Tamako0401/AMa-s-RISCV/docs/platform.md

# CPU 仿真与板级地址约定

以下地址用于当前 CPU 回归和 RIB SoC：指令 ROM 与数据 RAM 分离，复位入口为 ROM 基址。CPU 扩展能力、测试保留区及验证边界见 [cpu-baseline.md](cpu-baseline.md)。

Architecture:
    RV32I
    little-endian
    ABI = ilp32

Reset vector:
    0x00000000 (soc_top 默认, CPU/SoC 测试用); 板级顶层设为 0x0000f800 (bootloader, 见 bootloader.md)

ROM (instruction):
    0x00000000 - 0x0000ffff
    64 KiB
    fetch port: read-only, wired directly to the CPU ibus (not through RIB)
    data port:  RIB slave 0, used for rodata/constants and bootloader writes

Fetch/data paths:
    ibus -> ROM fetch port          (dedicated, 1-cycle, no arbitration)
    dbus -> RIB master 1 -> ROM data port / RAM / peripheral bus
    RIB master 0 is unused
    => code must live in the ROM window; soc_top cannot fetch from RAM

RAM (data):
    0x10000000 - 0x1000ffff
    64 KiB

Stack:
    initial sp = 0x10010000

MMIO:
    RIB slot s2 (0x20000000) = video: registers + palette/sprites/map/tiles, see video.md
    RIB slot s3 (0x30000000) is free
    RIB slot s4 (0x40000000) = peripheral bus, 4 KiB per port by addr[15:12]:
        0x40000000 unused (reads return zero, writes discarded)
        0x40001000 UART (CTRL/STATUS/BAUD/TXDATA/RXDATA at 0/4/8/C/10)
        0x40002000 SPI  (CR1/CR2/SR/DR at 0/4/8/C)
        0x40003000 GPIO matrix (all board pins, including UART/SPI)
        0x40004000 SYSCTL (HW_ID/ROM_WE)
        0x40005000 vision input (color tracking, see vision.md)
        0x40006000 handnet accelerator (registers, see nn.md)
        0x40007000 UART2 (same registers as UART; pins chosen by the GPIO matrix, unconnected at reset)
        0x40008000 audio (square + noise channels, I2S out via the GPIO matrix, see audio.md)
    CPU/SoC tests reserve RAM word 0x10000000 for completion

Interrupt:
    none

CSR:
    inherited M-mode CSR/trap paths; basic directed tests only

Misaligned access:
    unsupported initially
