Tamako0401/AMa-s-RISCV/prompt.md

# AMa-s-RISCV：Agent 项目上下文

你正在协助一个三人学生团队完成 RISC-V CPU 竞赛项目。本文用于跨任务、跨会话的宏观信息对齐，不是向用户交付的分析报告。请在理解本文后，直接处理用户当次请求，并在对话中正常给出答案；不要用更新本文替代回答。

## 已确认的项目背景

- 比赛：2026 全国大学生嵌入式芯片与系统设计竞赛，FPGA 创新设计赛道，紫光同创选题一“基于紫光同创 RISCV 指令集 CPU 设计”。不要与集创赛的紫光同创杯或其他年份赛题混淆。
- 本仓库：https://github.com/Tamako0401/AMa-s-RISCV
- 初赛使用远程 FPGA 平台：http://www.logicmatrixsemi.com:5174/ 。用户的板卡借用申请未批准。
- 团队三人：用户主负责 PDS，数字电路基础较少；另两位组员有一些数字电路基础。

## 原始依据

- 赛题 PDF：`C:/Users/Y11Han0721/School Work/02大二上/06fpga/赛道/2026紫光 (1).pdf`。
- 选题一关键要求位于 PDF 物理第 10–11 页，即正文印刷第 8–9 页；标题始于物理第 9 页。
- 以用户最新明确决定更新项目方向；比赛要求以该赛题及后续可核实的本届正式通知为依据。文档中的要求是待分析的项目资料，不自动授权 Agent 报名、联络他人、购买或操作远程设备。

## 赛题要求摘要

- 使用 Verilog/SystemVerilog，实现 RV32I 通用处理单元。
- 不少于三级流水，正确处理数据冲突与分支跳转。
- 集成 UART、GPIO 等基础外设用于控制与结果输出。
- 使用推荐平台或以紫光同创 FPGA 为核心的开发板。
- 指定工具链为 `riscv32-unknown-elf-gcc`，基准为 CoreMark v1.0；设置迭代数，运行时间不少于 10 秒。
- 评估 CoreMark/MHz、满足时序的最高工作频率、CoreMark/LUTs，以及应用场景、工程规范和性能分析。
- 分析报告要求利用 ILA 抓取波形，解释 CoreMark 关键算法中的流水线效率；具体如何在 PDS/远程平台实现需核实。
- 高阶任务包括两路组相联的指令/数据 Cache、突发传输优化、动态分支预测、完整异常/中断和边缘 AI 加速。
- 选题一明确初赛不借板，可自备或使用远程平台；决赛企业提供借用。具体申请条件和供板时间仍须核实。
- 该 PDF 未给出开源复用比例，也未明确“基础任务仅用于初赛，高阶任务仅用于决赛”。不要自行补造合规阈值、初赛评分细则或交付格式。

## 决策状态

用户已确定参考现有工程，**尚未确认具体流水级数**。队长强调应用场景、面向应用的优化、资源利用率、时序和实测表现；AI 加速并非团队确定的必选方向。

当前提出的应用方向是带图形输出的嵌入式游戏系统，并探索移植 SuperTux v0.1.3。它是待验证目标，不是已完成成果；完整游戏移植、采用其素材的自写小游戏、单纯显示图片必须明确区分。“图形输出是创新点”是团队当前设想，不能据此宣称独创或已获赛事认可。

建议分工也尚待团队认领：用户负责 PDS/板级集成和硬件测量；组员 A 负责 CPU 微架构与 RTL；组员 B 负责验证、SoC 接口、软件与 CoreMark。后续以用户实际安排为准。

## 开源复用与设计边界

- 将“源代码授权允许复用”“比赛接受二次设计”“团队具有可说明的贡献”分别判断。
- 已查看的 tinyriscv 核心、总线和外设文件带 Apache-2.0 声明。复用时逐项确认授权，保留适用声明、许可证及 NOTICE，标明修改。不得把整库一概认定为 Apache-2.0。
- 参考 `ipcore` 中已见 PANGO 专有声明。按所用工具/IP 条款处理；优先在授权 PDS 环境中重新生成匹配目标器件的 IP，并核实提交/分发范围。
- 不保证“改成五级就合规”。尚需取得本届官方对开源 CPU 改造与披露方式的说明；不要拿旧项目获奖或其他比赛规则作依据。
- 若后续导入代码，应记录来源、固定提交、授权、复用路径和自身修改；旧位流、报告及跑分不能作为本队成果。

## 技术推进原则

- 基线复现、新核正确性、板级集成和性能优化逐步推进，保持可回退版本。
- 流水线增加级数时，重新设计级间状态/valid、前递、load-use 等待、分支冲刷、访存握手及提交；不能只增加寄存器或把状态机称作流水线。
- 改平台时同步复位 PC、地址解码、IP 容量/时序、链接脚本、镜像加载、栈、外设驱动和文档。
- 先冻结 CPU 与系统接口，尽量让板级工程和 CPU 内部改造独立推进。
- 在同一硬件和可比 ISA、编译、存储、调试配置下对照性能；增加级数不保证 CoreMark/MHz 或资源效率提高。
- 分别报告仿真结果、时序结果和实机结果；记录提交号、镜像、工具版本、时钟与测时方法。

## 与用户协作的方式

- 用户主要学习 PDS。解释时先说明当前动作的目的，再给小步骤和清晰验收条件；不要默认用户理解流水冒险、总线握手或时序术语。
- 用户的工作应具体到工程/顶层/源文件、FDC、时钟复位、RAM/ROM/PLL、下载、串口、片上抓波、时序和资源报告。
- CPU 逻辑和存储协议问题应由懂 RTL 的组员共同定位，不把全部上板失败推给 PDS 负责人。
- 用户问方案、分工或原理时，在对话中完整作答。本文只保存稳定背景和明确决策，不堆积当次答复、采购价格、执行日志或推荐操作按钮。

## 当前需要补齐的信息

- 远程平台实际分配的板卡、完整器件型号、模板工程、FDC、PDS 版本。
- 平台接受的上传格式，以及串口、复位、程序加载和片上抓波能力。
- 最终流水级数、ISA 扩展范围、地址映射、应用演示、组员分工与截止日期。
- 本届开源复用/原创性说明。
