Tamako0401/AMa-s-RISCV/docs/hand-model.md

# 徒手手势模型

目标: 摄像头画面里找一只手, 给出手掌中心位置和握拳 / 张开两种手势, 控制游戏 (东方类: 位置控制自机, 握拳放 bomb;
水果忍者: 张开时挥手出刀光)。先在 Python 里验证, 达标后再做成 FPGA 上的加速器。
为什么不用颜色标记或帧差: 见 [vision.md](vision.md) 的算法试验。

## 先试玩: 手势控制能不能玩

训练自己的模型之前, 先用 MediaPipe 当输入把游戏做成能玩的原型 (`model/play.py`, 东方式弹幕):
握拳移动控制自机, 张开一下放 bomb。摄像头放在桌面附近、拍不到脸。

- 对照: 按 M 换鼠标玩同一关。鼠标也躲不过是游戏太难, 鼠标能玩、手不能玩才是输入的问题。
- 按 0~3 给手的位置加噪声 (160x120 画面里 σ = 0/1/2/4 点), 看多大的误差还能玩, 作为自己模型位置精度的验收线。
- 每局结束终端打印: 坚持几秒、得分、被击中几次、用了几个 bomb、摄像头帧率、没找到手的比例、识别耗时。

```sh
model/play.py models/gesture_recognizer.task                 # 第二个参数可以换摄像头编号
model/play.py models/gesture_recognizer.task --record ps front # 边玩边录, 之后用 label.py 标注
model/play.py models/gesture_recognizer.task --student model/runs/<名字>.pt   # 用自己训练的模型玩
```

`--student` 时游戏由自己的模型控制, MediaPipe 照样跑, 只在小窗里画出来对照 (绿点 MediaPipe, 红圈自己的模型),
屏幕上显示热力图分数; `--threshold` 改"分数低于多少算没找到手" (默认 0.5)。

画面和录数据一样, 是镜像后裁成 4:3 的 640x480 (板子 HDMI 输入看到的范围)。

## 流程和进度

| 步骤 | 脚本 | 状态 |
| --- | --- | --- |
| 1. 按固定动作清单录 640x480 画面 | `model/record.py` | 已写 |
| 2. MediaPipe 当老师自动标注 | `model/label.py` | 已写 |
| 3. 抽查标注, 手工点一批真值 | `model/check.py` | 待写 |
| 4. 训练小 CNN (浮点) | `model/handnet.py`、`model/train.py` | 已写, 第一版结果见结论记录 |
| 5. 评估 (按人分开的测试集) | `train.py` 里 (每 10 轮按段打表), `--val-person` 按人留出 | 等多人数据 |
| 6. 比较输入尺寸 (80x60 / 160x120 / 320x240) 和网络宽度 | 同上 | 待做 |
| 7. 实时试玩: 平滑、手势防抖、简单自机和刀光 | `model/demo.py` | 待写 |
| 8. INT8 量化, 写整数参考实现 (以后 C 和 RTL 的标准答案) | `model/nn_export.py`、`model/nnref.py` | 已写, RTL 见 [handnet 加速器](nn.md); 权重还要用真实数据重训 |

## 录数据、汇总、训练

全部在仓库里做, 数据放 `model/data/`, 训练结果放 `model/runs/`, MediaPipe 模型放 `models/`; 这三处都不进 git
(`.gitignore`)。脚本是 `uv run --script`, 第一次运行自动装依赖。训练有 NVIDIA 显卡 (CUDA) 或 Mac (MPS) 就用, 否则用 CPU。

第一次准备 (每台机器一次):

```sh
mkdir -p models && curl -L -o models/gesture_recognizer.task \
  https://storage.googleapis.com/mediapipe-models/gesture_recognizer/gesture_recognizer/float16/latest/gesture_recognizer.task
```

每个人、每种场景录一次, 再标注:

```sh
model/record.py <人> <场景>          # 跟着屏幕提示做 13 段动作, 约 2 分钟; 存到 model/data/<日期>_<人>_<场景>_<时分秒>/
model/label.py models/gesture_recognizer.task model/data/<刚录的目录>   # MediaPipe 自动标注, 打印每段统计
```

- **人**: 同一个人每次用同一个名字 (字母数字, 如 ps、yh), 训练时按它分训练集和验证集。
- **场景**: front (顺光)、back (逆光, 比如背后是窗)、messy (背景杂乱) 等, 名字自己定, 统计里按它分开数。
- 摄像头在显示器上方对着人, 手在胸前 (见上面"结论记录": 平拍不好玩, 老师也认不出手势)。
- 录多少: 至少 4~5 个人, 每人 2~3 种场景。一次约 1000 帧、70 MB, 15 次约 1 GB。
- 边玩边录也算数据, 正好是游戏里真实的手部动作: `model/play.py models/gesture_recognizer.task --record <人> <场景>`。

汇总不同人的数据: 每次录制是一个自带全部信息的目录 (图片 + `meta.json` 记着人和场景, 标注后多一个 `labels.npz`),
目录名带时间, 不会重名。所以汇总就是**把这些目录都放进训练那台机器的 `model/data/`**:

- 别人在自己电脑上录: 装好仓库后照上面录, 把 `model/data/<目录>` 打包 (zip) 发过来, 解压到 `model/data/`。
  没标注的在这边补跑 `label.py`。数据太大不走 git, 用网盘或 U 盘。
- 或者人来这台机器前录, 直接就在 `model/data/` 里。

训练 (`model/data` 下所有标注过的 session; 一个人整个留出来当验证集, 看对没见过的人好不好用):

```sh
model/train.py model/data --val-person ps --width 16
```

开训前会按人、场景打印 session 数和帧数, 看数据偏不偏。存到 `model/runs/w16_160_<时间>.pt`。
最后导出给硬件 (标定直接用录的数据):

```sh
model/nn_export.py model/runs/<名字>.pt --calib model/data   # 改写 rtl/nn/ 的权重和 tests/nn/ 的测试向量
./ama test tests/nn                                         # RTL 和整数参考逐字节对上
```

### 外部数据: HaGRID

自己录的人少、背景少。补上 HaGRID (https://github.com/hukenovs/hagrid, 上万人用手机拍的手势照片, 许可 CC BY-SA 4.0,
用了要在文档和答辩材料里注明出处) 的 384p 抽样版
(https://huggingface.co/datasets/cj-mills/hagrid-sample-120k-384p, 3.5 GB zip, 同样 CC BY-SA 4.0), 只用 fist、palm、stop 三类:

```sh
mkdir -p model/external   # 不进 git
curl -L -C - -o model/external/hagrid-sample-120k-384p.zip \
  https://huggingface.co/datasets/cj-mills/hagrid-sample-120k-384p/resolve/main/hagrid-sample-120k-384p.zip
model/import_hagrid.py model/external/hagrid-sample-120k-384p.zip   # 每类 2000 张 -> model/data/<日期>_hg00..hg09_hagrid_000000
model/label.py models/gesture_recognizer.task model/data/*_hg*_hagrid_*   # 照片逐张标 (IMAGE 模式)
```

导入时裁成 4:3、让手占画面宽度 10%~25% (和摄像头在显示器上方时差不多), 再缩到 640x480; 同一个人的照片在同一组,
组名 hg00..hg09 当人名, 所以 `--val-person` 仍然只该留自己录的真人 (要看的是对我们摄像头好不好用)。
都是静止照片, 没有运动模糊和逆光, 补不了这些, 只补人和背景的多样性。

## 结构试验

默认结构的最后一格在 160x120 里只看得到约 47x47 点 (感受野), 手离镜头近时有 60~80 点大, 第一次训练的漏检里
"手太近太大"是一类。`train.py` 有两个选项扩大感受野, 先在 PyTorch 里比漏检和 P95, 明显变好再改硬件:

| 选项 | 感受野 | 乘加 / 帧 (宽度 16) | 参数 | 硬件 |
| --- | --- | --- | --- | --- |
| 默认 | 约 47 点 | 6.44 M | 13.9 k | 支持 |
| `--dw-k 5` (不缩小的块用 5x5 深度卷积) | 约 79 点 | 7.06 M | 15.9 k | 支持 (2026-10-27 起, 现在导出的默认结构) |
| `--extra 1` (多一个不缩小的块) | 约 63 点 | 7.84 M | 18.8 k | 层表支持, `nn_export.py` 还要跟着加层 |
| `--dw-k 5 --extra 1` | 约 111 点 | 8.76 M | 21.9 k | 两样都要 |

`nn_export.py` 遇到 `--extra` 不为 0 的模型会直接报错, 不会导出硬件跑不了的权重。

## 数据

一次录制 (session) 是一个目录: 帧图片 (640x480 JPEG, 已左右镜像)、`meta.json` (人、场景、每帧属于哪段和时间戳)、
`labels.npz` (标注)。动作清单在 `record.py` 的 `SEGMENTS`, 按游戏的玩法排 (平时握拳移动, 张开一下放 bomb;
摄像头在显示器上方对着人, 手在胸前): 握拳 / 张开静止、握拳移动、握拳快速移动、移动中张开一下、转手 (掌心 / 侧面 / 手背)、换另一只手、
远近移动、手进出画面边缘、手在脸附近, 以及没有手、脸凑近 (负样本)、两只手。每段记着"应该看到什么" (写在 `meta.json`),
`label.py` 用它找标注的问题。`play.py --record` 录的段名是 `play`, 不核对。

存的是 640x480 原图, 训练时再缩到要的尺寸, 缩小方法和硬件一样 (`box4` 的整块平均)。这样比较 80x60 / 160x120 /
320x240 或以后换分辨率都不用重录。2026-10-23 第一次录制用的是旧清单 (摄像头对着人、平时张开), 照样能用。

`labels.npz` 每个字段第一维是帧, 最多记两只手 (按左右排); 坐标都是 0..1 的比例, 换成任何分辨率乘宽高即可:

| 字段 | 形状 | 意思 |
| --- | --- | --- |
| `files`、`segment` | N | 图片文件名、属于哪段 |
| `hands` | N | 找到几只手 |
| `points` | N×2×21×2 | MediaPipe 的 21 个关键点; 没有的手是 NaN |
| `center` | N×2×2 | 手掌中心: 手腕和四个指根 (0、5、9、13、17 号点) 的平均 |
| `teacher`、`teacher_score` | N×2 | Gesture Recognizer 的结果: 0 握拳, 1 张开, -1 其他; 置信度 |
| `ratios`、`rule` | N×2×4、N×2 | 四指 (指尖到手腕) / (指根到手腕), 和按它判的手势 |
| `gesture` | N×2 | 最终手势: 一路说不清时听另一路, 两路矛盾或都说不清为 -1 (训练时不算) |

录数据的要求: 测试集里的人不能出现在训练集 (所以 `record.py` 要写人名); 人数比总帧数重要, 目标 6~10 人、每人
2~3 种光线和背景。

## 网络

`model/handnet.py`。输入 160x120 (从 640x480 每 4x4 块取平均, 和硬件 `box4` 一样), 输出 20x15 个格, 每格 4 个数:

```
160x120x3 ─ 3x3 卷积 /2 ─ 80x60xW ─ 可分离 /2 ─ 40x30x2W ─ 可分离 /2 ─ 20x15x4W ─ 可分离 ×2 ─ 1x1 卷积 ─ 20x15x4
                                                                                            ├ 热力图 (手心在这格的分数)
可分离 = 3x3 深度卷积 + 1x1 卷积 (MobileNet)                                                  ├ 格内偏移 dx, dy
W = 宽度 (--width)                                                                           └ 握拳的分数
```

找手: 取热力图最高的格, 分数 ≥ 0.5 算有手; 手心 = (格 + 偏移) × 8; 手势读同一格。没有上采样和跳连 (不是 UNet)。

训练 (`model/train.py`): 损失 = 热力图 focal loss + 偏移 L1 + 手势交叉熵, 后两项只在手心那格算。
数据增强: 左右翻转、平移缩放、每通道颜色增益、亮度对比度、噪声、模糊。

## 用到的方法

只记确实在用或确定会用的; 每条一句话说清楚它是什么、我们为什么用。

- **伪标签训练 (老师-学生)**: 用一个准但大的模型 (老师, MediaPipe) 给数据自动打标签, 拿来训练一个小模型 (学生)。
  省掉手工标注; 代价是学生会学到老师的错, 所以要抽查, 还要一批人工真值来量误差。
  这是广义的知识蒸馏 (Hinton 2015), 更接近 Radosavovic 2018 的 *Data Distillation*。
- **MediaPipe Hands / Gesture Recognizer** (Zhang 2020, arXiv 2006.10214): Google 的手部模型, 先在整张图 (192x192)
  上找手掌, 再在手的区域里出 21 个关键点; Gesture Recognizer 在此基础上分 7 种手势, 包括 Closed_Fist、Open_Palm。
  它专门检测手掌而不是整只手, 理由是手掌形状固定好找, 我们取手掌中心也是这个道理 (握拳不会让中心跳)。
- **两路标签交叉检查**: 手势同时用老师的分类和手指弯曲比例的规则判; 一路说不清时听另一路, 两路矛盾就不用这帧。
  规则用 MediaPipe 的 world 坐标 (以手为原点的三维坐标), 手转个角度比值也不怎么变。
- **按人划分测试集**: 同一个人既在训练集又在测试集, 模型会记住这个人的手和背景, 指标虚高。
- **CenterNet 式输出** (Zhou 2019, *Objects as Points*): 网络输出一张粗网格 (比如 20x15) 的热力图, 手心所在格分数最高;
  再输出格内的小数偏移, 精度就不受格子大小限制。不需要 UNet 那种放大回原图的解码器, 硬件上省存储。
- **focal loss** (Lin 2017, RetinaNet): 热力图上几乎全是背景格, 普通损失会被背景淹没; focal loss 降低"已经判对的
  简单格"的权重, 让训练集中在难的格上。
- **深度可分离卷积** (MobileNet, Howard 2017): 主干用它, 计算量比普通卷积少 8~9 倍。
- **One Euro 滤波** (Casiez 2012): 平滑位置, 手慢时多平滑 (去抖), 手快时少平滑 (不拖尾)。用在 CPU 后处理。
- **量化感知训练** (Jacob 2018): 训练时就模拟 INT8 的取整误差, 让模型适应; 硬件上只用整数乘加。做到第 8 步时再展开。

## 结论记录

按日期往下记: 用了什么数据、什么配置、指标多少、得出什么结论。

- 2026-10-23: `record.py`、`label.py` 写好。`label.py` 用 MediaPipe 示例图试过: 竖拇指时规则判握拳、老师判 Thumb_Up,
  两路不一致标 -1, 符合预期。
- 2026-10-23 第一次录制 (ps, 顺光, 1273 帧, USB 摄像头):
  - 没有手、脸凑近两段老师 0 误检; 两只手段 99% 找到两只。
  - 手势两路**从未直接矛盾**, 只是各有说不清的时候: 老师常对移动中的拳头给 None (move_fist 22%), 规则常对移动中
    微弯的张开手说不清 (比值掉到 1.5 左右)。原来"两路一致才用"会丢掉约 1/5 的移动帧, 正好是游戏里最常见的状态,
    所以改成一路说不清时听另一路。改后忽略比例: 移动握拳 6%、切换 4%、换手 11%。
  - 规则比值: 握拳静止 0.58~0.88, 张开静止 1.63~1.85, 阈值 1.2 / 1.6 先不动。
  - 老师漏检: other_hand 段开头约 20 帧是在换手、画面里确实没手 (标对了); 真漏的是拳头在画面边缘、
    快速挥手的模糊帧、**手挡在脸前**。所以训练时"没有手"的负样本只取 no_hand / face 段, 有手的段里老师没找到手的帧
    不当负样本, 直接不用; 手挡脸是游戏里常见的姿势, 老师在这里弱, 要靠 check.py 手工补标。
- 2026-10-23 第一次试玩 (`play.py`, Mac 前置摄像头 30 帧/秒, MediaPipe 识别约 22 ms/帧, 噪声 0, 平滑开):
  正常两局坚持 46、47 秒, 被击中 3、2 次, bomb 3 个都用了, 没找到手 6%、0%。
  弹幕密度 (第一级圆环、自机狙、螺旋) 能躲; 过程中自机没有跳, 手势没有误识别。结论: 位置 + 两种手势的控制方式可行。
  试玩后改成平时握拳、张开一下放 bomb (原来反过来), 防抖改成两个方向都要连续 3 帧才切换。
- 2026-10-23 噪声试玩 (同上设置, 每档只玩了 1~3 局, 差异只能看大方向):

  | 噪声 σ | 平滑 | 坚持 (秒) |
  | --- | --- | --- |
  | 1 | 开 | 37、26、47 |
  | 2 | 开 | 26、54 |
  | 2 | 关 | 22 |
  | 1 | 关 | 11 (这局 49% 没找到手, 不算) |

  - **平滑必须开**: 关掉后自机一直在抖, 主观感受"超级离谱"; 开着时 σ=1、2 都能玩, 两档分不出明显差别。
  - 这里的噪声是每帧独立的高斯抖动 (围着真实位置跳), 平滑能压掉大半, 所以影响不大, 主观上只是要往弹幕稀的地方躲。
    自己的模型的误差不一定是这样: 可能有固定偏差 (某些手势中心整体偏一点) 或偶尔跳到别处, 这两种平滑压不掉,
    评估时要单独统计 (P95 误差、大于 10 点的次数)。
  - 平滑越强越稳但越滞后, 要在精度和延迟之间取平衡。暂定验收线: 160x120 下位置误差 σ ≤ 2 点, 配默认 One Euro 参数。
- 2026-10-23 试了摄像头放桌面平拍 (USB 免驱摄像头, 画面裁成 4:3):
  - 试玩明显变难: 三局坚持 16、40、19 秒 (之前对着人时 46、47 秒)。手离镜头近, 在画面里很大, 能移动的范围小;
    手要伸远一些, 也不在平时的位置, 控制别扭。
  - 老师的手势分类几乎全失效: 各段 83%~100% 给"其他" (平拍多是拳头侧面, 不像它训练时见过的掌心朝镜头),
    手势只剩规则一路在判; 找手本身还是 96%~100%。
  - 结论: 摄像头回到显示器上方对着人, 手放在胸前。录制清单加回"脸凑近"(负样本) 和"手在脸附近移动",
    训练后专门看脸上的误检。
- 2026-10-23 第一次训练 (只有 ps 一个人; 训练: front_003156、desk_012710、两次边玩边录, 约 5000 帧;
  验证: face_013812, 新清单、摄像头对着人; 输入 160x120, 30 轮, Mac 的 GPU 上每轮约 8 秒):

  | 网络 | 乘加 / 帧 | 参数 | 漏检 | 误差中位 | P95 | >10 点 | 脸上误检 | 手势对 |
  | --- | --- | --- | --- | --- | --- | --- | --- | --- |
  | 宽度 8 | 2.3 M | 4.2 k | 32% | 3.8 | 21.2 | 14% | 21% (15/75) | 96% |
  | 宽度 16 | 6.4 M | 13.9 k | 23% | 3.6 | 25.2 | 16% | 0% | 96% |
  | 宽度 16 + 左右翻转 | 6.4 M | 13.9 k | 21% | 2.8 | 11.4 | 7% | 0% | 99% |

  误差单位是 160x120 画面里的点, 和老师 (MediaPipe) 的手心比。
  - 换手段误差一直在 19 点左右: 画出来看, 是另一只手 (左手) 的拳头, 学生把点放在拳头中间, 老师在靠手腕一侧。
    训练数据几乎只有右手; 加左右翻转后这段中位误差 19.5 → 6.8, 整体 P95 25 → 11。
  - 手和脸能分开: 宽度 16 在只有脸的帧上 0 误检, 手在脸前 (near_face) 中位误差 2.6。
  - 主要问题是漏检 (21%), 多在手转到侧面 (turn)、换手、手太近太大、半只手在边上; 分数常在 0.2~0.4,
    阈值 0.5 可能偏高。下一步: 学生模型接进 play.py 试玩, 看漏检对手感的影响; 找更多人录数据。
- 2026-10-23 第一次用自己的模型试玩 (`play.py --student`, 宽度 16 + 左右翻转那版, 阈值 0.5):
  三局坚持 43、18、80 秒 (MediaPipe 时 44、47 秒), 没找到手 8%、1%、1%, 自己的模型每帧约 5 ms (CPU)。
  主观: 已经可用。少量突然的中短距离跳变, 有几段小幅抖动, 不如 MediaPipe 平滑。
- 2026-10-27 结构和外部数据对比 (宽度 16, 30 轮, RTX 上训练; 验证集同上 face_013812, 1500 个有手帧):

  | 训练数据 | 结构 | 漏检 | 误差中位 | P95 | >10 点 | 手势对 |
  | --- | --- | --- | --- | --- | --- | --- |
  | ps 4 次 (同 10-23) | 默认, 跑两次 | 27%、28% | 3.8、3.8 | 21.6、18.3 | 13%、13% | 97%、96% |
  | ps 4 次 | `--dw-k 5`, 跑两次 | 15%、13% | 3.1、3.7 | 16.8、15.8 | 10%、11% | 97%、93% |
  | ps 5 次 (加 10-27 那次) | 默认 | 28% | 3.0 | 16.0 | 9% | 99% |
  | ps 5 次 + HaGRID 6000 张 | 默认 | 39% | 2.9 | 8.3 | 4% | 99% |

  - **5x5 深度卷积 (感受野 47 -> 79 点) 漏检减半**, 两次都是, 不是随机波动。硬件已经加上 (层表的核大小可以是 5, 见 docs/nn.md)。
  - **HaGRID 让定位准很多** (P95 16 -> 8.3, 换手段 27 -> 22, 远近段 30 -> 5.7), 但漏检反而多了: 照片里都是
    静止、清楚、掌心朝镜头的手, 模型对我们的模糊、侧面、半只手更不敢说 "有"。下一步: HaGRID 少放一些或降权,
    和 `--dw-k 5` 一起试, 再看阈值 (现在 0.5) 要不要按验证集调。
