Tamako0401/AMa-s-RISCV/boards/ego1/pins.xdc

# 由 ama gen pins 生成, 不要手改
set_property PACKAGE_PIN B16 [get_ports {io[0]}]
set_property IOSTANDARD LVCMOS33 [get_ports {io[0]}]
set_property SLEW SLOW [get_ports {io[0]}]
set_property DRIVE 4 [get_ports {io[0]}]
set_property PACKAGE_PIN B17 [get_ports {io[1]}]
set_property IOSTANDARD LVCMOS33 [get_ports {io[1]}]
set_property SLEW SLOW [get_ports {io[1]}]
set_property DRIVE 4 [get_ports {io[1]}]
set_property PACKAGE_PIN A15 [get_ports {io[2]}]
set_property IOSTANDARD LVCMOS33 [get_ports {io[2]}]
set_property SLEW SLOW [get_ports {io[2]}]
set_property DRIVE 4 [get_ports {io[2]}]
set_property PACKAGE_PIN A16 [get_ports {io[3]}]
set_property IOSTANDARD LVCMOS33 [get_ports {io[3]}]
set_property SLEW SLOW [get_ports {io[3]}]
set_property DRIVE 4 [get_ports {io[3]}]
set_property PACKAGE_PIN A13 [get_ports {io[4]}]
set_property IOSTANDARD LVCMOS33 [get_ports {io[4]}]
set_property SLEW SLOW [get_ports {io[4]}]
set_property DRIVE 4 [get_ports {io[4]}]
set_property PACKAGE_PIN A14 [get_ports {io[5]}]
set_property IOSTANDARD LVCMOS33 [get_ports {io[5]}]
set_property SLEW SLOW [get_ports {io[5]}]
set_property DRIVE 4 [get_ports {io[5]}]
set_property PACKAGE_PIN B18 [get_ports {io[6]}]
set_property IOSTANDARD LVCMOS33 [get_ports {io[6]}]
set_property SLEW SLOW [get_ports {io[6]}]
set_property DRIVE 4 [get_ports {io[6]}]
set_property PACKAGE_PIN A18 [get_ports {io[7]}]
set_property IOSTANDARD LVCMOS33 [get_ports {io[7]}]
set_property SLEW SLOW [get_ports {io[7]}]
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
set_property PACKAGE_PIN T4 [get_ports {io[69]}]
set_property IOSTANDARD LVCMOS33 [get_ports {io[69]}]
set_property SLEW SLOW [get_ports {io[69]}]
set_property DRIVE 4 [get_ports {io[69]}]
set_property PACKAGE_PIN N5 [get_ports {io[70]}]
set_property IOSTANDARD LVCMOS33 [get_ports {io[70]}]
