Tamako0401/AMa-s-RISCV/sw/bsp/mes2l100hp_pins.h

/* 由 ama gen pins 生成, 不要手改 */
#define PIN_LCD_SCK 0
#define PIN_LCD_MOSI 1
#define PIN_LCD_CS 2
#define PIN_LCD_DC 3
#define PIN_LCD_RST 4
#define PIN_LCD_BL 5
#define PIN_EXP1 6
#define PIN_EXP2 7
#define PIN_KEY1 8
#define PIN_KEY2 9
#define PIN_KEY3 10
#define PIN_KEY4 11
#define PIN_LED1 12
#define PIN_LED2 13
#define PIN_LED3 14
#define PIN_LED4 15
#define PIN_LED5 16
#define PIN_LED6 17
#define PIN_LED7 18
#define PIN_LED8 19
#define PIN_UART_TX 20
#define PIN_UART_RX 21
#define PIN_HDMI_RSTN 22
#define PIN_HDMI_SCL 23
#define PIN_HDMI_SDA 24
#define PIN_CAM_PCLK 25
#define PIN_CAM_VSYNC 26
#define PIN_CAM_HREF 27
#define PIN_CAM_XCLK 28
#define PIN_CAM_D0 29
#define PIN_CAM_D1 30
#define PIN_CAM_D2 31
#define PIN_CAM_D3 32
#define PIN_CAM_D4 33
#define PIN_CAM_D5 34
#define PIN_CAM_D6 35
#define PIN_CAM_D7 36
#define PIN_CAM_SCL 37
#define PIN_CAM_SDA 38
#define PIN_CAM_RST 39
#define PIN_CAM_PWDN 40
#define PIN_WS_TX 41
#define PIN_WS_RX 42
#define PIN_WS_EN 43
#define PIN_WS_IO9 44
#define PIN_PHY_RX 45
#define PIN_PHY_TX 46
#define PIN_AMP_BCLK 47
#define PIN_AMP_LRCK 48
#define PIN_AMP_DIN 49
#define PIN_AMP_SD 50
#define PIN_EXT29 51
#define PIN_EXT30 52
#define PIN_EXT31 53
#define PIN_EXT32 54
#define PIN_EXT33 55
#define PIN_EXT34 56
#define PIN_EXP35 57
#define PIN_EXP36 58
#define PIN_SD_SCK 59
#define PIN_SD_MOSI 60
#define PIN_SD_MISO 61
#define PIN_SD_CS 62
#define PIN_SD_DET 63
