Tamako0401/AMa-s-RISCV/sw/bsp/mes50hp_pins.h

/* 由 ama gen pins 生成, 不要手改 */
#define PIN_J8_3 0
#define PIN_J8_4 1
#define PIN_J8_5 2
#define PIN_J8_6 3
#define PIN_J8_7 4
#define PIN_J8_8 5
#define PIN_J8_9 6
#define PIN_J8_10 7
#define PIN_J8_11 8
#define PIN_J8_12 9
#define PIN_J8_13 10
#define PIN_J8_14 11
#define PIN_J8_15 12
#define PIN_J8_16 13
#define PIN_J8_17 14
#define PIN_J8_18 15
#define PIN_J8_19 16
#define PIN_J8_20 17
#define PIN_J8_21 18
#define PIN_J8_22 19
#define PIN_J8_23 20
#define PIN_J8_24 21
#define PIN_J8_25 22
#define PIN_J8_26 23
#define PIN_J8_27 24
#define PIN_J8_28 25
#define PIN_J8_29 26
#define PIN_J8_30 27
#define PIN_J8_31 28
#define PIN_J8_32 29
#define PIN_J8_33 30
#define PIN_J8_34 31
#define PIN_J8_35 32
#define PIN_J8_36 33
#define PIN_PMOD_1 34
#define PIN_PMOD_2 35
#define PIN_PMOD_3 36
#define PIN_PMOD_4 37
#define PIN_PMOD_7 38
#define PIN_PMOD_8 39
#define PIN_PMOD_9 40
#define PIN_PMOD_10 41
#define PIN_KEY2 42
#define PIN_KEY3 43
#define PIN_KEY4 44
#define PIN_KEY5 45
#define PIN_KEY6 46
#define PIN_KEY7 47
#define PIN_KEY8 48
#define PIN_LED1 49
#define PIN_LED2 50
#define PIN_LED3 51
#define PIN_LED4 52
#define PIN_LED5 53
#define PIN_LED6 54
#define PIN_LED7 55
#define PIN_LED8 56
#define PIN_UART_TX 57
#define PIN_UART_RX 58
#define PIN_HDMI_RSTN 59
#define PIN_HDMI_SCL 60
#define PIN_HDMI_SDA 61
#define PIN_HDMI_RX_SCL 62
#define PIN_HDMI_RX_SDA 63
