Tamako0401/AMa-s-RISCV/sw/bsp/ego1_pins.h

/* 由 ama gen pins 生成, 不要手改 */
#define PIN_J5_1 0
#define PIN_J5_2 1
#define PIN_J5_3 2
#define PIN_J5_4 3
#define PIN_J5_5 4
#define PIN_J5_6 5
#define PIN_J5_7 6
#define PIN_J5_8 7
#define PIN_J5_9 8
#define PIN_J5_10 9
#define PIN_J5_11 10
#define PIN_J5_12 11
#define PIN_J5_13 12
#define PIN_J5_14 13
#define PIN_J5_15 14
#define PIN_J5_16 15
#define PIN_J5_17 16
#define PIN_J5_18 17
#define PIN_J5_19 18
#define PIN_J5_20 19
#define PIN_J5_21 20
#define PIN_J5_22 21
#define PIN_J5_23 22
#define PIN_J5_24 23
#define PIN_J5_25 24
#define PIN_J5_26 25
#define PIN_J5_27 26
#define PIN_J5_28 27
#define PIN_J5_29 28
#define PIN_J5_30 29
#define PIN_J5_31 30
#define PIN_J5_32 31
#define PIN_S0 32
#define PIN_S1 33
#define PIN_S2 34
#define PIN_S3 35
#define PIN_S4 36
#define PIN_SW0 37
#define PIN_SW1 38
#define PIN_SW2 39
#define PIN_SW3 40
#define PIN_SW4 41
#define PIN_SW5 42
#define PIN_SW6 43
#define PIN_SW7 44
#define PIN_DIP0 45
#define PIN_DIP1 46
#define PIN_DIP2 47
#define PIN_DIP3 48
#define PIN_DIP4 49
#define PIN_DIP5 50
#define PIN_DIP6 51
#define PIN_DIP7 52
#define PIN_LD2_0 53
#define PIN_LD2_1 54
#define PIN_LD2_2 55
#define PIN_LD2_3 56
#define PIN_LD2_4 57
#define PIN_LD2_5 58
#define PIN_LD2_6 59
#define PIN_LD2_7 60
#define PIN_LD1_0 61
#define PIN_LD1_1 62
#define PIN_LD1_2 63
#define PIN_LD1_3 64
#define PIN_LD1_4 65
#define PIN_LD1_5 66
#define PIN_LD1_6 67
#define PIN_LD1_7 68
#define PIN_UART_TX 69
#define PIN_UART_RX 70
