Tamako0401/AMa-s-RISCV/(commit log)

2026-09-13 feat(sw): 新增链接脚本和主程序文件
    同步队友的最新更改
2026-09-19 feat(experiments): 添加 8 位寄存器及自检仿真测试
2026-09-25 feat(rtl): 移植基础数据通路和通用组件并记录来源
2026-09-25 feat(peripherals): 移植 GPIO 和可配置时钟的 UART
2026-09-25 test(rtl): 添加移植组件自检与接入说明
2026-09-27 feat(cpu): add CSR interrupt and divider support
2026-09-29 feat(perips): add the ROM and RAM bus slaves
    去 IP 化移植上游的 ram.v/rom.v: 存储体改用 rtl/utils/gen_ram.v, 总线侧沿用
    perips 已有的 valid/ready 约定(req_valid/req_ready + rsp_valid/rsp_ready),
    因此可以直接挂到 rib 的从设备端口。
    - rom.v: 只读, 初值由 $readmemh 从 ROM_INIT_FILE 载入; DP 真正决定深度
    (上游的 DP 是死参数, 实际用的是硬编码位宽)。
    - ram.v: 复用 gen_ram; 写使能包含握手(we_i & req_valid_i & req_ready_o),
    主设备保持 we_i 等待响应时不会重复写入。
    - 一并挂进 rtl/reusable.f, 并新增组件回归 tests/reusable/memory_tb.sv。
2026-09-29 feat(core): default the reset vector to the ROM base
    哈佛式布局下指令存储器(ROM)位于 0x0000_0000, 复位向量随之从 0x8000_0000 改为
    0x0000_0000, 与 rtl/core/rib.v 的从设备译码一致。
    cpu_tb 一直是显式传参(.RESET_PC(BASE)), 所以这个默认值的改动不影响既有的
    核级仿真基线。
    [ifu.v, tinyriscv_core.v]
2026-09-29 test(cpu): move the baseline harness to the Harvard memory map
    - link.ld: 单区域 -> ROM 0x0000_0000(.text/.rodata) + RAM 0x1000_0000
    (.data/.bss/栈); RAM 窗口第 0 个字保留为"运行结束"信箱, 可用 RAM 从 +4 开始。
    - cpu_tb.sv: 单数组 -> rom[]/ram[] 两块独立模型, +image= 改为 +rom=/+ram=;
    取指只走 ROM, 数据总线可读 ROM(.rodata 常量)但写被忽略, 与 rom.v 行为一致。
    - memory.S: 自改写代码用例在哈佛下本质上不成立(ROM 不可写, 也不能从 RAM 取指),
    改为验证"写 ROM 必须被忽略"——仍是 fence.i + jal/ret 的覆盖。
    验证: 15 组程序/延迟配置全部 PASS。
2026-09-29 refactor(sw): point link.ld at the Harvard memory map
    sw/link.ld 原先把代码、数据和栈全放在 0x8000_0000 一块统一内存里, 改成与
    rtl/core/rib.v 的从设备译码一致的两区布局: ROM 0x0000_0000(.text/.rodata,
    也是复位向量) + RAM 0x1000_0000(.data/.bss/栈)。
    sw/startup.S 与 sw/main.c 不需要改动: 它们只用链接器符号(_stack_top、
    _bss_start/_bss_end、__global_pointer$), 不含硬编码地址。
    与 tests/cpu/link.ld 的差异是有意的: 那边把 RAM 窗口第 0 个字留给仿真结果
    信箱, 可用 RAM 从 +4 开始; 本文件面向实机程序, 程序原地停机, 不保留信箱。
2026-09-29 test(cpu): build the two images the Harvard harness expects
    cpu_tb 改成双存储器后, 测试台改用 +rom= 与 +ram= 两个镜像参数, 但构建脚本
    没有同步: 它仍然只导出二进制并传 +image=, 因此在那个提交点上跑
    python scripts/test-cpu.py 会立刻 $fatal("Missing +rom=hex")。本次补齐:
    - 用 llvm-objcopy --only-section 分别导出 .text(ROM) 与 .data(RAM);
    - 两个镜像都补齐到 64 KiB: ROM 未初始化部分填 0xa5(非法指令), RAM 数据区
    之后填 0xa5, 继续保证 startup 真正清 BSS;
    - vvp 参数由 +image= 改为 +rom= / +ram=;
    - 按 link.ld 约定, .data 之前补 4 字节, 把 RAM 窗口第 0 个字留给结果信箱;
    - memory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
2026-09-29 test(reusable): run the memory regression from test-reusable.nu
    上一批次新增了 rtl/perips/rom.v、ram.v 和 tests/reusable/memory_tb.sv, 并把
    它们挂进了 rtl/reusable.f, 但脚本的测试列表没跟上, memory_tb 不会被这个脚本
    跑到。补上列表项。
    验证: storage / alu / peripherals / memory 四组均 PASS。
2026-09-29 docs: record the Harvard memory map and the baseline conventions
    - platform.md: 复位向量 0x0000_0000; 指令存储器 ROM 0x0000_0000-0x0000_ffff
    (64 KiB, 只读); 数据存储器 RAM 0x1000_0000-0x1000_ffff(64 KiB); 栈顶 0x1001_0000。
    - cpu-baseline.md: 仿真侧同步为哈佛式双存储模型, 记录"取指只走 ROM、数据总线
    可读 ROM 但写被忽略"以及"向 RAM 窗口第 0 个字写 4 字节表示结束"的信箱约定;
    另加"已知环境问题"一节, 说明 Icarus 13 无法展开 rtl/core/exu_muldiv.v
    (div_ready 先用后声明), 本机因此跑不了 test-cpu.py。
2026-09-29 feat(soc): add the valid/ready RIB interconnect
    rib.v 是处理器核与从设备之间的总线互连(2 个主设备 x 5 个从设备), 主从两侧都
    用 valid/ready 握手。上游也有一个 valid/ready 版 rib, 但它的响应路由依赖
    "当前仲裁结果 + 当前地址", 而本核在请求握手后就撤 req_valid(见 exu_mem 的
    pending/ifu 的 WAIT), 会把响应送回错误的主设备。
    本次重写为在请求握手时锁存事务归属(owner + 目标从设备), 并去掉旧版依赖的
    defines.v 宏(MemAddrBus/MemBus/HoldEnable 等, 本仓库已不存在)和 hold_flag_o。
    同时新增 rtl/soc.f, 把 rib 纳入可编译的文件清单。
2026-09-29 feat(soc): add the core+memory SoC top and its smoke test
    - rtl/soc_top/soc_top.v: 例化 tinyriscv_core + rib + rom + ram, 按哈佛映射把
    ibus/dbus 接到 rib 的 m0/m1、ROM 接 s0、RAM 接 s1(各 64 KiB, 与 link.ld 一致);
    s2~s4 保留(不握手), 留给后续的 uart/gpio/spi。
    - tests/soc/: SoC 级测试台直接跑在 RTL 的 rib+rom+ram 上(核级回归用的是测试台
    自己的行为级存储模型), 另有专用冒烟程序; 测试台还检查 rib 的互斥性 ——
    任一时刻最多一个从设备被选中、最多一个主设备收到响应。
    - scripts/test-soc.py: 构建并运行该用例。
    验证: PASS SoC cycles=1193 stores=19。
2026-09-29 feat(perips): preload RAM contents from an init file
    soc_top 里的 ram.v 之前没有初值支持, RAM 上电内容是未知值, 因此任何带已初始化
    .data 的程序都无法在 SoC 上运行(之前的 SoC 冒烟程序只能刻意绕开 .data)。
    - rtl/utils/gen_ram.v: 新增可选 INIT_FILE 参数, 用守卫生效的 $readmemh 载入
    存储初值; 文件名为空则完全不初始化, 行为向后兼容。
    - rtl/perips/ram.v: 新增 RAM_INIT_FILE, 透传给 gen_ram。
    - rtl/soc_top/soc_top.v: 新增 RAM_INIT_FILE, 透传给 u_ram。
    - tests/reusable: 新增 ram_init.mem; memory_tb 的 RAM 改为带初值实例, 并在
    任何写之前逐字读回校验。
    - tests/soc: 新增 soc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
2026-09-29 feat(perips): add the SPI master
    从上游移植 spi master 模块(rstl 高有效风格, 无 valid/ready 总线接口)。
    注意: 它还没有接入 SoC —— rib 的从设备侧是 valid/ready 握手, 而本模块仍是
    旧式接口(data_i/addr_i/we_i + data_o), 因此接上去之前需要先写一层总线包装;
    目前也不在任何 .f 清单或回归里。
2026-09-29 refactor(perips): adapt the SPI master to the peripheral bus protocol
    rtl/perips/spi.v 是从别的项目复制过来的, 其接口是本仓库早已废弃的旧风格, 无法
    挂到 rib 上。SPI 移位状态机本身没有缺陷, 本次只改接口层, 收发逻辑一行未动。
    - rst -> rst_n: 原代码的复位判断写的是 rst == 1'b0, 即它本来就是低有效, 只是
    端口名有误导性。本次统一成仓库惯用的 rst_n(7 处判断, 无语义变化)。
    - 新增 sel_i[3:0] 字节使能: 原来 we_i 一到就整字写入, 字节/半字写会误伤同一字
    的其它字节。SPI_CTRL/SPI_DATA/SPI_DC 三个可写寄存器改为按字节写, 与 gpio.v、
    uart.v 一致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
2026-09-29 feat(soc): wire the SPI master into the RIB at slave 2
    - rtl/soc_top/soc_top.v: rib 的从设备 2 从"保留、不握手"改为接入 spi, 地址
    0x2000_0000; 新增 6 个顶层引脚 spi_mosi/spi_miso/spi_ss/spi_clk/lcd_dc/
    lcd_rst_n; 从设备 3/4 仍然保留。头部注释同步更新地址映射。
    - rtl/soc.f: 把 spi.v 纳入 SoC 文件清单。
    - tests/soc/soc_spi.S: 新增。5 次写, 全部通过总线读写 SPI 寄存器 -- DC 复位值、
    DC 回读、CTRL 回读(bit0 自清)、sb 字节写、STATUS 只读; 最后启动一次传输并轮询
    STATUS[0] 由忙转闲, 证明重构后状态机仍然会跑。这是第一条走通
    dbus -> rib -> spi 这条从设备通路的程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
2026-09-29 feat(difftest): 加入.tohost使得满足条件后spike可以停止
2026-09-29 fix: 修复一个先使用后声明
2026-09-29 feat(difftest): 加入commit log日志开关
2026-09-29 feat(difftest): 加入一个简单的difftest
2026-09-29 fix: 修改链接脚本以适应哈佛架构
2026-09-30 feat(board): add verified MES50HP minimal system and firmware
2026-09-30 docs(platform): reconcile CPU baseline, board layout and provenance
2026-09-30 feat(spi): adopt CR1 SR DR and GPIO screen controls
2026-09-30 docs(spi): document register migration and verification
2026-10-01 fix(uart): 在cpu没空时保存uart要给的值不丢掉
2026-10-01 feat(soc): 将uart接入到s3并将gpio 8~15连接led
2026-10-01 feat(bus): 加入外设子总线
2026-10-01 refactor(soc): 把gpio, uart和spi挂到外设子总线s4下
2026-10-01 feat(sw): 分层sw, spi/lcd驱动以及lcd_demo
2026-10-01 docs(axi): 对axi的真实控制器部分的补充
2026-10-02 docs(readme): 更新 README 文件以反映当前项目进展和系统配置
2026-10-03 test(spi): test spi display in simulator
2026-10-04 feat(ci): 添加 GitHub Actions 工作流以自动运行 Icarus/Verilator 验收测试
2026-10-07 feat: Enhance minimal SoC with SPI support and LCD integration
    - Updated minimal_soc.v to include SPI interface and control signals for the LCD.
    - Modified build-board.py to support building firmware for SPI LCD demo.
    - Implemented lcd_main.c for SPI LCD demonstration, showcasing basic graphics.
    - Added board_lcd_tb.sv for testing the LCD functionality in the simulation environment.
    - Adjusted GPIO configurations to accommodate new peripherals and ensure correct operation.
    - Enhanced ST7789 initialization sequence in st7789.c for improved compatibility.
    [board_lcd_tb.sv, board_tb.sv, lcd_main.c, main.c, mes50hp_top.v, minimal_soc.v, st7789.c]
2026-10-08 feat: 更新 README 和脚本以支持 LCD 上板SRAM快速测试，添加引脚约束核对报告
2026-10-09 fix(ci): 板级测试台改用例化参数覆盖，修复 Verilator 报错
    CI 上 Verilator 不支持带层级路径的 defparam (dut.soc.MEM_FILE)，
    导致 board_tb/board_lcd_tb 编译失败；本地无 Verilator 回退 Icarus
    故未暴露。改为 mes50hp_top 透传 MEM_FILE 参数、测试台在例化时以
    #(.MEM_FILE("sim.hex")) 覆盖，Icarus/Verilator 均兼容；参数默认值
    仍为 firmware.hex，PDS 位流行为不变。本地两步板级仿真均 PASS。
    [board_lcd_tb.sv, board_tb.sv, mes50hp_top.v]
2026-10-09 fix: 使用bsrr切换led, 避免影响其他gpio
2026-10-16 feat(sw): .data 初值放 ROM, 启动时拷到 RAM, 复位行为与单片机一致
    片上存储不随复位恢复, 原来 .data 只靠配置时预装 RAM, 程序改过的变量
    在复位后不会回到初值。
    - sw/link.ld: .data > RAM AT > ROM, 导出 _data_load/_data_start/_data_end
    - sw/startup.S: 清 BSS 前把 .data 初值从 ROM 拷到 RAM
    - scripts/elf2hex.py: 按 ELF 程序头的存放地址生成 ROM 镜像, 单独负责 ELF -> hex
    - scripts/test-lcd.py: 改用 elf2hex.py, 只给 +rom=; 加 --tb 选择测试台
    - sw/app/reset_check + tests/soc/reset_tb.sv: 改掉变量后复位, 检查初值恢复
    ram.v 的 RAM_INIT_FILE 保留, CPU 回归 (tests/cpu、test-soc、difftest) 仍在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
    [lcd_tb.sv, main.c, reset_tb.sv]
2026-10-16 feat(sw): UART 驱动和上板自检程序 board_check
    - sw/device/amarisc.h: UART 寄存器 (0x4000_1000)
    - sw/drivers/uart.{c,h}: 轮询收发; uart_init 写成 inline, 常量参数下编译期算分频
    (rv32i 无除法指令, -nostdlib 下运行时除法链接不到 __udivsi3)
    - sw/bsp: LED/调试串口接线, bsp_cycles / bsp_ms_to_cycles
    - sw/app/board_check: 打印 AMA CPU PASS/FAIL n, 回显, LED 流水; 改掉有初值的
    变量, KEY1 复位后检查是否从 ROM 恢复。输出与 sw/board/main.c 相同, 复用板级测试台
    - justfile、test-lcd.py 的源文件列表加上 uart.c
    [amarisc.h, bsp.c, bsp.h, main.c, uart.c, uart.h]
2026-10-16 feat(board): soc_top 上板 (build-board.py --harvard)
    - boards/mes50hp/mes50hp_top_harvard.v: soc_top 的板级顶层, 端口与模块名同
    mes50hp_top.v, 共用 mes50hp.fdc 和板级测试台; KEY1 异步复位同步释放, RX 两级同步
    - scripts/build-board.py --harvard: 固件用 sw/ (startup.S、link.ld, app 为
    board_check 或 --lcd 时 lcd_demo), ROM 镜像用 elf2hex.py, RTL 用 rtl/soc.f;
    输出 build/mes50hp-harvard[-lcd]。不加 --harvard 时 minimal_soc 流程不变
    - tests/board/board_lcd_tb.sv: -DHARVARD 时按 soc_top 的 u_core 取总线信号
    - CI: 加哈佛版板级仿真、LCD 仿真和复位恢复测试
    - boards/mes50hp/README.md: 哈佛版用法与验收
    仿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
2026-10-16 fix(uart): 软件写 STATUS 的那一拍不再跳过硬件更新
    STATUS 原先用一个 if/else: 软件写 STATUS (清 RX 完成标志) 的那一拍, else 里的
    硬件更新整个被跳过。两种后果, 都只在恰好同拍时发生:
    - 正好是 TX 停止位结束: TX busy 永远不清, putc 死等, 串口再也不出字;
    - 正好收完一个新字节: RX 完成标志被清掉, 这个字节丢失。
    改为两个标志各自更新: TX busy 只由硬件置位/清除; RX 完成标志接收置位优先于软件清除。
    tests/reusable/uart_status_tb.sv 在两个事件前后各扫 3 拍写入时刻, 修复前两项都在
    偏移 0 失败, 修复后通过; 已加入 test-reusable.nu (CI 组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
    [uart.v, uart_status_tb.sv]
2026-10-16 fix(sw): bsp_ms_to_cycles 改为 static inline, 避免 clang 18 生成 __mulsi3 调用
    [bsp.c, bsp.h]
2026-10-16 test(soc): reset_tb 超时改用计数器, 兼容 Verilator 5.020
    [reset_tb.sv]
2026-10-16 feat(sw): 移植 CoreMark 到 soc_top (sw/app/coremark, scripts/coremark.py, build-board.py --app coremark)
2026-10-16 ci: 拆成并行 job 并加 lint; CoreMark 支持 gcc 并检查性能底线
    - ci.yml: 固定 ubuntu-24.04, permissions: contents: read, concurrency 取消旧运行,
    每个 job 设超时; Nushell 下载包校验 SHA-256; cpu / soc / board / coremark / lint
    五个 job 并行, 失败时上传日志
    - coremark.py: --cc gcc (赛题指定工具链)、--min-score 性能底线、--summary 结果表;
    CI 中 clang 与 gcc 各跑一次 (ubuntu-24.04 实测 clang 18 0.558, GCC 13.2 0.660)
    - check-coremark-upstream.py: 校验 third_party/coremark 与官方 1f483d5 逐字节一致
    - lint job: ruff、actionlint、CoreMark 原样性; verilator -Wall 只报告不阻断
    - build-board.py / test-cpu.py: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
2026-10-16 ci: coremark 安装步骤的数组改名, 通过 actionlint 的 shellcheck 检查
2026-10-16 feat(boards): 支持在 EGO1 (Artix-7) 上构建哈佛 SoC 位流
    boards/ego1: ego1_top 例化 mes50hp_top, MMCM 把 100 MHz 分成 50 MHz,
    S6 (低有效) 作复位; build-board.py --board ego1 --harvard [--app coremark] --vivado
    在 distrobox 里跑 Vivado。MES50HP 构建不变。
    Vivado 2025.2 实测: board_check WNS +0.732 ns / 4157 LUT, coremark WNS +1.009 ns / 7477 LUT。
2026-10-16 fix(rtl): rom 地址寄存器去掉异步复位, 让 ROM 推断成块 RAM
    带异步复位的 addr_r 无法映射到 BRAM, 综合器只能用 LUT 搭整个 ROM, LUT 随程序变大。
    EGO1 (Vivado 2025.2) 实测: board_check 4157 -> 3223 LUT, coremark 7477 -> 3223 LUT,
    RAMB36 16 -> 32, WNS +1.009 -> +0.250 ns。复位后的 addr_r 不被读取 (rsp_valid_o 由
    vld_rdy 给出), 仿真周期数不变; 实机 board_check 与 CoreMark 均通过。
    [rom.v]
2026-10-16 test(directed): 补充已知缺陷的定向复现测试
2026-10-16 feat(boards): build-board.py 支持 --cc gcc, 用于 CoreMark 正式报分
2026-10-16 fix(uart): 上电和复位期间保持 TX 空闲高电平
    UART 的 tx_bit 复位值为 0 且没有上电初值, EGO1 在 S6 按下或 MMCM
    未锁定时把 TX 拉低, 主机将其视为起始位。根因在 UART 输出寄存器,
    因此修改 rtl/perips/uart.v 的初值和复位值, 不在板级或固件绕过。
    新增 uart_reset_tb, 从无时钟的上电阶段开始检查引脚, 按 115200 8N1
    解码真实 board_check 固件, 覆盖停钟和正常时钟下的重复复位。
    接入 build-board.py --harvard --simulate, 不改 CI。
    修复前 1 ns 即因 TX=0 失败; 复位波形另可见 120.32 us 的低电平。
    回归: SoC 4 项、CPU 15 项、组件、SPI、reset_check、EGO1/MES50HP
    Harv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
    [uart.v, uart_reset_tb.sv]
2026-10-18 feat(rtl): GPIO 矩阵、可写 ROM 和系统控制寄存器
    新增 gpio_matrix (0x4000_3000), 仿 ESP32: 任何外设信号可以接到任何引脚。
    板上所有资源 (扩展口、按键、开关、LED、串口) 都接进位流, 接什么由 C 运行时
    决定, 接新外设或换插针不再改 .v、不再综合。寄存器名照抄 ESP32 (OUT/W1TS/
    W1TC/ENABLE/IN/FUNC_OUT_SEL/FUNC_IN_SEL), 规格见 docs/gpio-matrix.md。
    控制台串口也经矩阵, 复位默认接板载 USB 转串口, 不配置就能用。
    地址按字段直接选寄存器: 最初逐引脚比较地址的写法有 30 级逻辑,
    EGO1 50 MHz 下 WNS -1.09 ns。
    为串口 bootloader 加两样硬件 (docs/bootloader.md):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
2026-10-18 refactor(sw): 外设驱动改用 GPIO 矩阵, 屏幕移出 bsp
    - 新驱动 sw/drivers/io.h: io_dir / io_write / io_read / io_connect_out /
    io_connect_in, 用 W1TS/W1TC 写, 不做读改写。
    - bsp 只描述板子本身: 按 BOARD_EGO1 / BOARD_MES50HP 选引脚头文件,
    去掉基于旧 GPIO 的 LED/按键/屏幕引脚定义。
    - 屏幕是插上去的模块, 不属于板子: bsp/bsp_lcd.c 移到
    components/lcd/lcd_io.c。app 用 lcd_pins_t 按名字给出屏幕接在哪几个脚,
    调对应的 lcd_init_xxx; SPI 模式和最高速度是屏幕芯片的参数, 由驱动自己定。
    宽高由驱动初始化时设置 (lcd_width/lcd_height), 去掉 LCD_W/LCD_H 编译宏。
    - 新增 ST7735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
2026-10-18 feat(boards): 引脚表、矩阵板级顶层和串口 bootloader
    引脚表: boards/<板>/pins.csv 记录电路板上焊死的事实 (丝印名、管脚、方向),
    scripts/gen-pins.py 由它生成约束、顶层用的 pins_top.vh 和
    sw/bsp/<板>_pins.h (PIN_J5_1、PIN_S0、PIN_KEY2 ...), 三处不会对不上。
    - EGO1: J5 32 个插针、S0~S4、SW0~7、DIP0~7、16 个 LED、串口。
    - 盘古: J8 34 个 IO、PMOD 8 个、KEY2~8 (低有效, 顶层取反)、LED1~8、串口。
    复位键 (EGO1 S6、盘古 KEY1) 和时钟固定在顶层, 不进矩阵。
    板级顶层: ego1_top 改写、新增 mes50hp_top_matrix, 只有时钟、复位和一排 io;
    旧 mes50hp_top*.v 不动。
    串口 bootloader (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
    [pins.csv]
2026-10-18 feat(app): EGO1 自检程序和贪吃蛇
    ego1_check: 屏幕三色带加白框、5 个按键方块, LED 跟随按键, 串口每秒打印
    按键状态; 是 EGO1 位流里固化的默认程序, 新板子先跑它排查接线。
    snake: 网格按屏幕运行时宽高计算 (ST7735 128x160 每格 8 像素,
    ST7789 240x320 每格 10 像素)。
    - EGO1: S4/S3/S0/S1 方向, S2 开局/暂停; SW0 穿墙, SW1 串口控制, LD2-0/1 指示。
    - 盘古: KEY5~8 = h/j/k/l, KEY2 开局/暂停; KEY3 串口控制、KEY4 穿墙
    (按一下切换), LED3/4 指示。
    - 串口: wasd/hjkl 方向, p 或空格开局/暂停。
    - 穿墙关闭时撞墙结束; 撞死后停 1 秒, 免得按着方向键立刻重开。
    验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
2026-10-18 feat(tools): ama 上板工具 (uv + typer)
    日常改 C 不再综合: ama run <程序> 编译、经串口 bootloader 下载、显示串口
    输出, 几秒完成; 只有改了 rtl/、boards/、sw/boot/ 才用 ama fpga build /
    ama fpga program。命令名照 ESP-IDF、PlatformIO 的叫法:
    ama run | build | upload | monitor | sim <程序>
    ama fpga build | program
    - 依赖写在脚本头部 (PEP 723), 由 uv 自动安装 typer、pyserial。
    Linux/macOS 直接 ./ama, Windows 用 uv run --script ama。
    - 板子按 USB 串口芯片识别 (FT2232 = EGO1, CP2102 = 盘古), 也可 --board。
    - 下载前核对板上位流的 HW_ID; fpga build 在位流旁记下 HW_ID,
    fpga program 拒绝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
2026-10-18 fix(build): 修正 MES50HP 板的比特流文件路径和 HW_ID 参数写入编码
2026-10-20 refactor(sw): 按键组件、app 板级接线、屏幕 shield, 三个自检程序合成 selftest
    - components/key: 定时采样 + 消抖, key_ticks 每轮调一次, key_rose/key_fell/key_status 只读
    - app 的板级差异放 sw/app/<app>/boards/<板>/ (app_board.h/.c), ama 编译时按板子加 -I 和源文件;
    snake 改用它, main.c 不再出现板子名
    - bsp/shield_lcd.h: 每块板约定的屏幕型号和接线, app 调 shield_lcd_init()
    - selftest 取代 board_check、ego1_check、lcd_demo: CPU 自检 -> 测试图 -> LED 流水、回显、按键方块
    (README、位流和板级测试台下一步改)
    - ama fpga build/program 必须写程序名, 不再按板子写死默认程序
    - ama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
2026-10-20 refactor: minimal_soc 整套移到 legacy/, 盘古只留一个 mes50hp_top
    - legacy/minimal_soc/: minimal_soc.v、它的板级顶层和约束、sw/board 固件、board_lcd_tb、
    board_reset 缺陷复现; 不再构建, README 说明来源和最后可用的提交
    - 删 mes50hp_top_harvard.v (没人用); mes50hp_top_matrix.v -> mes50hp_top.v,
    matrix.fdc -> mes50hp.fdc
    - build-board.py 去掉 minimal_soc 路径和 --lcd; 板级测试台去掉 HARVARD 分支
    过渡状态: build-board.py 和 CI 下一步由 ama 取代。
2026-10-20 refactor(ama): ama 成为唯一编译固件和生成位流的工具, 删 build-board.py
    - 代码挪进 tools/ama/ (cli、boards、firmware、fpga、load), 根目录 ama 只是入口
    - boards/<板>/board.toml 描述工具、器件、顶层、约束、USB 串口芯片、位流文件名
    - ama build <app> 出 build/fw/<板>/<app>/{app.elf,boot.elf,rom.hex}; 需要额外源文件的 app
    写 sw/app/<app>/app.toml (只有 coremark)
    - ama fpga build <app> 在 build/fpga/<板>-<app>/ 生成工程, build.tcl 用相对路径,
    PDS 可经 pds_remote 命令在虚拟机里跑; ama gen pins <板> 取代 gen-pins.py
    - 删 scripts/build-board.py、elf2hex.py、hwid.py、load.py、gen-pins.py
    - ama.local.t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
2026-10-20 refactor(test): ama test 取代所有测试脚本, CI 只跑 ama test
    - 每个测试目录一个 tests.toml ([[test]]: tb、rtl、extra、params、runs、expect、sim),
    tools/ama/testing.py 一段通用代码解释; ama test [目录|测试台]
    - 默认 verilator; sw/app/<app>/test/ 用电脑的 cc 编译运行
    - ALU 程序固定为 tests/cpu/alu.S; reset_check 挪到 tests/soc/ (reset_tb 的测试固件)
    - CoreMark 在固件里算 CoreMark/MHz 并和 -DMIN_SCORE 比较, 仿真用的 ITERATIONS 由测试传入
    - 板级测试台改用 selftest, boot_tb 自己算下载镜像的长度和 CRC
    - 删 scripts/*.nu、test-cpu.py、test-soc.py、test-lcd.py、test-directed.py、coremark.py、
    chec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
    [board_tb.sv, boot_tb.sv, cli.py, coremark_tb.sv, firmware.py, lcd_tb.sv, reset_check.c, reset_tb.sv]
2026-10-20 feat(sim): ama sim 跑任意程序, 实时窗口显示屏幕, 终端显示串口
2026-10-20 refactor(ama): 本机工具统一成同名命令的替身, ama doctor 列命令和版本
2026-10-20 feat(ama): ama lint / ama fmt, 带 --fix 才改文件
    [cli.py, firmware.py, lint.py, local.py]
2026-10-20 style: ama fmt --fix 统一 Python/C/Verilog 格式
    [alu_tb.sv, amarisc.h, axi_bridge.v, axi_bridge_tb.sv, axi_slave_model.sv, board_tb.sv]
2026-10-20 docs: 只删除过时、放错位置和混乱的内容
2026-10-20 refactor(ama): 固件只用 riscv64-unknown-elf-gcc, 去掉 --cc 和 clang
2026-10-20 docs(ama): ama 的 README 和命令图; 删 load.py 的旧命令行入口
2026-10-20 fix(ama): compile_commands.json 合并而不是覆盖
2026-10-20 refactor(sim): sim 外壳例化 mes50hp_top 当虚拟盘古板, 引脚编号来自 pins_top.vh
2026-10-20 feat(sim): 窗口里打字经串口送进程序
2026-10-20 fix(rtl): gpio_matrix 复位不在循环里对数组非阻塞赋值, verilator 5.020 能编
    [gpio_matrix.v]
2026-10-20 fix(ama): gcc 链接加 --nmagic, bootloader 没进 ROM 的问题; ROM 分区只在 sw/memory.ld; 硬件版本号补漏; FPGA 工具查表; 烧写按板; 测试台用 PIN_ 名字; ram_init 字段; 测试结果显示 [result]
    [board_tb.sv, boot_app.c, boot_tb.sv, cli.py, firmware.py, fpga.py, lcd_tb.sv, load.py]
2026-10-20 refactor(ama): 编译器按赛题叫 riscv32-unknown-elf-gcc, 没有就在 ama.local.toml 里起别名
2026-10-20 docs(sw): selftest 的 README; sw 分层表补全, 引脚功能只在 components/bsp 里选
2026-10-20 refactor(soc): 删旧 gpio.v 和不走矩阵的旧端口; gpio_matrix 的 genvar 改成 Verilog 写法 (PDS); fpga build 打印按模块资源表, 工具失败时给日志路径
2026-10-20 feat(ama): ama new <程序>, 从模板 sw/app/hello 复制
2026-10-20 docs(sw): snake、coremark 的 README
2026-10-20 ci: 测得的数值 (CoreMark/MHz) 写进运行摘要
2026-10-20 perf(core): ifu 改成预取队列加 epoch 丢弃, 同镜像 CoreMark/MHz 0.778 -> 1.113
    原来的 ifu 是 4 状态单笔事务状态机, 每条指令 IDLE/SEND/WAIT/FULL 各占一拍,
    实测 4.36 拍/条, 取指占了 CoreMark 测量窗口的 69%。
    改动:
    - 指令队列 + 在途标签队列: 队列还有余量就连续发请求, PC 不再等下游取走;
    - 标签记 {epoch, pc}, 响应按序配对, 交付的 pc 和 inst 永远来自同一次取指;
    - flush 只做 epoch+1、PC 改目标地址、清空指令队列; 在途响应照常接收后按
    epoch 丢弃, 不再等总线事务结束;
    - req_valid 拉高后保持到握手、期间地址不变, rsp_ready 恒为 1, 总线语义不变;
    -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
2026-10-20 style: 修 ama lint 报的问题 (rtl/core 以外); verible、clang-tidy 规则按代码库写法调整
    [alu_tb.sv, axi_bridge_tb.sv, boot_tb.sv, coremark_tb.sv, cpu_tb.sv, ego1_top.v, firmware.py, fpga.py]
2026-10-20 perf(soc): ROM 增加独立取指口, 取指不再和访存抢 rib
    rom.v 增加第二个只读口(i_*), 直接接 CPU 的 ibus; 原来接在 rib 上的口保留给
    数据访问(读 rodata/常量, bootloader 写 app 区)。两个口同拍访问互不阻塞。
    soc_top 把 ibus 从 rib 的主设备 0 改到 ROM 取指口, rib 主设备 0 保留未用。
    取指不再和 dbus 争同一笔总线事务。这是严格哈佛式划分: 指令必须位于 ROM
    窗口, soc_top 不再支持从 RAM 取指(现有链接脚本都把 .text 放在 ROM)。
    同一份 CoreMark 镜像 (3 次迭代, clang -O2, 50 MHz 仿真):
    4 状态机基线 3,854,726 ticks -> 0.778 CoreMark/MHz
    预取队列 + epo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
2026-10-20 ama: 位流默认只带 bootloader, --app 才固化程序; bootloader 见程序区为空就一直等下载
2026-10-20 ama: fpga program 默认写进 flash 上电自动加载, --once 只下载一次; 盘古改用 cdt_cfg_shell 命令行下载; docs: 参考项目
2026-10-20 video: HDMI 输出 640x480, 图块背景 + 16x16 精灵 + 调色板, 逐行渲染; MS7210 软件 I2C 初始化; 仿真窗口显示 HDMI; video_tb
    [pins.csv]
2026-10-20 sw: 软件 I2C 挪到 drivers, 速度由调用方传入, 不再依赖 bsp
2026-10-20 vision: HDMI 输入 -> 4x4 均值缩小 -> 160x120 小窗 (像素流各级可替换); MS7200 初始化; ama fpga report 打印每个模块和全片资源、各时钟余量
    [pins.csv]
2026-10-20 ama: fpga build 也必须写 --board (只和构建产物有关, 不按串口猜)
2026-10-21 model: 视觉算法 Python 试验 (帧差/消融/颜色标记, MediaPipe 当对照); docs: 试验结论
2026-10-21 vision: 颜色跟踪 (Cb/Cr 容差内的点数和坐标和, 寄存器 0x4000_5000, 和 model/color.py 逐位相同); video_demo 跟着红色标记画光标
2026-10-21 vision: 画面正中平均颜色寄存器, video_demo 串口 c 标定、+/- 调容差、打印位置
2026-10-21 sw: I2C 16 位寄存器地址改为低字节先发 (MS72xx 约定, 同盘古例程); 原来高字节在前, 自检读写同一地址照样通过, 其余寄存器全写错位置
2026-10-21 sw: MS72xx 每次寄存器读写后等 1 ms, 同盘古例程
2026-10-21 vision: 输入改为 800x600 (电脑最低只给这个), 裁出正中 640x480 再缩小; 仿真视频源改 800x600@60
2026-10-21 sw: MS7200 EDID 不再声明支持 YCbCr, 电脑只发 RGB
2026-10-21 perf(core): 访存不再多停一拍, 重定向当拍发出目标取指
    两处都只动 RTL, 不改编译器选项。
    1) exu_mem.v: 去掉多余的 done 拍
    原来是 请求握手 -> 响应 -> done -> 才放行 EX, 每条访存停 2 拍。done 只比
    响应晚一拍, 完全多余。现在响应那一拍就写回并放行 EX; 读数据在响应拍直接
    取总线值(rdata_sel), 其余时候用锁存值。pending 只由本条指令自己的请求置位,
    所以不会把前一条的响应误当自己的。
    mem_req_valid_o 也去掉 !done, 连续访存之间不再空一拍。
    2) ifu.v: 重定向当拍就发目标地址的请求
    原来 flush_i 把 issue_start 挡住, 目标地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
    [exu_mem.v, ifu.v]
2026-10-21 perf(core): 取指队列空时旁路响应, 重定向少等一拍
    原来的路径是 响应 -> 写指令队列 -> 下一拍从队列读出 -> 交给 ifu_idu, 队列为空
    时这一进一出纯属多余。现在队列空且下游这一拍就要拿走时, 直接把响应旁路到
    ifu_idu, 同时不进队列(避免重复交付)。
    停顿时下游拿不走, 这时必须常规入队, 否则这条指令会丢 —— fifo_bypass 的条件里
    带 !stall_i[STALL_ID] 就是为了这个。
    改动前 1,431,806 ticks -> 2.095 CoreMark/MHz
    改动后 1,329,197 ticks -> 2.257 CoreMark/MHz (+7.7%)
    省下的正好是每次重定向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
    [ifu.v]
2026-10-22 docs: 赛题要求与答疑要点; 修正过时内容 (HDMI 上板状态、输入分辨率问题、CoreMark 分数、复位地址)
2026-10-22 model: 手势数据录制 (record.py) 和 MediaPipe 自动标注 (label.py); docs: 徒手手势模型流程、方法和首次录制结论
2026-10-22 model: 手势弹幕试玩原型 (play.py, MediaPipe 输入, 可加位置噪声、开关平滑); docs: 试玩和噪声结论
2026-10-22 model: 录制清单按游戏玩法重排, play.py 改用 4:3 画面并可边玩边录; label.py 表头对齐、每段期望写进 meta.json; docs: 桌面平拍试验结论
2026-10-22 model: 手势小网络 (handnet.py) 和训练 (train.py, MediaPipe 标注当答案, 按段打验证指标); docs: 网络结构和第一次训练结果
2026-10-22 model: play.py 可用自己训练的模型控制 (--student, 小窗同时画 MediaPipe 对照); docs: 第一次用自己模型试玩
2026-10-22 docs: 显示扩展方案草案 (720p、逐行渲染 + 多图层、软硬件分工、预算和要验证的问题、游戏用 C 写并带电脑后端)
2026-10-22 video: 增加 720p 扫描和双时钟行缓存，保留 VGA 回退
2026-10-22 vision: 测量输入尺寸并整帧验证后发布居中裁剪结果
2026-10-22 test: 覆盖 SoC 和板级双显示模式并记录 HDMI 验证边界
2026-10-22 game: 东方式弹幕的 C 版 (游戏逻辑只用整数, 板上照用) 和电脑后端 (SDL2、UDP 收手的结果、每行负载统计、存帧); model: hand_send.py 把识别结果发给游戏
2026-10-23 perf(core): 加入 32 项 BTB, 取指阶段预测分支目标
    原来每次分支都要到 EX 算出目标才重定向, 取指空等 3~4 拍; 实测 103,038 次
    重定向占总周期的 26%。现在取指时就查表拿到目标, 直接沿预测路径取指。
    新增 rtl/core/btb.v:
    - 32 项, 索引 PC[6:2], tag PC[31:7];
    - 表项 {valid, tag, target, counter[1:0]}, counter[1] 为 1 时预测跳转;
    - 计数器饱和增减; 未命中且本次跳转才分配, 初值 2(弱跳);
    - 同拍读写同一格做 write-through 旁路, 刚训练的分支立刻能命中。
    关键取舍: 目标地址是查表读出来的, 不是现算的, 取指地址路径上不新增加法器,
    只多了一次小表查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
2026-10-23 game: 水果忍者式 (水果、炸弹、切开的两半、汁水、刀光、连击); 电脑后端拆出两个游戏共用的 app.c; gfx 加整体混色 (闪白); 手的有效区按游戏区宽高比算; README 记下结构和水果忍者带来的硬件需求
2026-10-23 game: 显示硬件的 Python 参考模型 (refmodel.py: 逐像素画出硬件该出的画面、数每行拍数); 存帧加上底色、小窗、文字层; README 记下和电脑版的比对和每行预算的结论
2026-10-23 game: 参考模型加 memory (按块 RAM 的拼法列出整个 SoC 要的存储, 和两块板比); README 记下结论
2026-10-23 rom: 按真双口块 RAM 的写法重写 (数据口读写、取指口只读, 各自寄存输出), 避免 PDS 把 64 KB 复制成两份; 待综合确认块数
2026-10-23 game: 参考模型加 colors (图案按 RGB565 / 共用 256 色 / 每张 16 色画同一帧比较, --shaded 模拟颜色多的素材), memory 可按 8 位图案算; touhou --bot 放一次 bomb; README 记下色深的结论
2026-10-23 rom: 只接受整字写入 (引导程序只按字写), 免得 PDS 按字节通道拆开再复制
2026-10-23 game: 电脑上窗口不是 1280x720 时用线性插值缩放 (最近邻把文字缩坏); 参考模型加刀光层试验 (render --blade-layer)
2026-10-23 game: 电脑上窗口不是 1280x720 时用线性插值缩放 (最近邻把文字缩坏)
2026-10-23 game: 水果忍者的刀光改成顺着轨迹摆旋转的细长笔画; 果汁加果汁团和木板上的果汁印; 新图案 streak、drop_*、stain_*
2026-10-23 docs: display-plan 记下电脑上五项验证的结论
2026-10-23 game: 字库在 Linux 上用 fc-match 找等宽字体 (原来只认 macOS 的 Menlo)
2026-10-24 rtl: handnet int8 加速器 (rtl/nn), 权重和层表由脚本生成
    一层一层跑完 model/handnet.py 那张网络, 挂在 RIB 子总线 0x4000_6000:
    - 16 路 int8 乘加并行 (一个 128 位字 = 16 个输出通道), int32 累加;
    普通卷积按输出通道并行, depthwise 按通道并行。
    - 每输出通道一个 int32 定点乘数, 每层一个右移位数和量化零点; ReLU 的下限
    取零点, 越界 (padding) 的输入取 pad_q。输入定点化 (q = pixel - 128, BGR)
    在硬件里做。
    - 权重 ROM 1024x128 位、乘数/偏置 ROM 512x64 位, 都在片上; 输入 RAM
    19200x32 位, 特征缓冲 A/B 乒乓 4800/1200 个 128 位字。
    - 存储一律用 dpram/nn_rom, 不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
2026-10-24 sw: handnet 驱动、解码和两层验证
    C 侧 (header-only, 不用改链接脚本):
    - sw/nn/nn.h: 寄存器访问。nn_load/nn_start/nn_wait/nn_checksum, 送一张
    160x120 RGB888 (硬件负责 BGR 排序和 q = pixel - 128)。
    - sw/nn/nn_post.h: 把 300 个格子解成手心位置和握拳 (nn_hand_t)。
    - sw/nn/nn_tables.h: sigmoid 查表、输出尺寸, 由 nn_export.py 生成。
    - sw/app/nn_demo: 造一张图跑一遍, 串口打印位置/握拳/送图与推理的拍数/校验和,
    两块板都能编。造图是边算边写, 不在 RAM 里留整帧 (64 KiB 放不下)。
    - amarisc.h 加 NN 寄存器; ama 的固件 include 路径加 sw/nn。
    验证:
    - tests/nn/nn_tb.sv: 走总线送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
2026-10-24 docs: handnet 加速器 (寄存器、存储、时序、换权重、用法)
    - docs/nn.md: 为什么用 MMIO 而不是自定义指令 (一次推理 72 万拍, 长延时指令
    等于整核停住); 并行方式和定点化的式子; 每层乘加; 寄存器表; C 库用法;
    存储明细 (约 186 KiB 块 RAM, 100K 板约 1/4, 50K 放不下); 时序实测;
    换权重的三个命令; 两级测试; PDS 需要确认的地方; 下一步 (相机直连、
    省存储、提吞吐)。
    - docs/platform.md: 外设总线加 0x40006000。
    - docs/hand-model.md: 第 8 步 (INT8 量化 + 整数参考实现) 标成已写, 并指向
    docs/nn.md。
    - README: 仓库导航加 rtl/nn/ 和 docs/nn.md。
    Co-authore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
2026-10-24 boards: 盘古100Pro+ (MES2L676-100HP / PG2L100H) 板级工程; 测试台和固件按板参数化; bootloader/测试程序编译补上 -DBOARD (波特率原先按 50 MHz 写死)
    [pins.csv]
2026-10-24 boards: mes2l100hp 加 GPLL 27->50MHz 系统时钟 (VCO 675, RATIO0=13.5); Verilator 旁路 PLL, 软件常数与 50K 板对齐
2026-10-24 ama: fpga build 给 build_boot 补传板名 (加 -DBOARD 改签名时漏了这处调用)
2026-10-24 ama: fpga check 综合前静态检查 (管脚重复/参照库核对、GPLL 边界、SYSCLK_HZ 对账), fpga build 自动预检; padrefs.csv 由例程 FDC+手册生成
    [padrefs.csv]
2026-10-25 ama: 帮助文案和 README 认上 mes2l100hp (两块盘古串口芯片相同, 下载数据要 -b 区分)
2026-10-25 tests: $value$plusargs 返回值用 void' 丢弃, 修 CI 上 nn_check 误超时
    Verilator <= 5.026 会把返回值没人使用的 $value$plusargs 调用当死代码
    优化掉 (verilator#5127, 5.028 修复), 塞给没人读的 integer 正是这种写法。
    CI 的 Ubuntu 24.04 apt 包是 5.020: soc_tb 的 +cycles=4000000 从未生效,
    nn_check (要跑 173 万拍) 按默认 20 万拍超时; cpu_tb 的 +stores 核对也被
    静默跳过。本地 5.040 没有此 bug, 所以本地 PASS、CI 红。sim/ 里两处裸
    调用一并改掉。
    ubuntu:24.04 容器 (Verilator 5.020) 实测: nn_check 在 1732841 拍 PASS
    (与本地 5.040 一致); 传错的 +stores=6 (实际 7) 正确触发 fatal。
    [cpu_tb.sv, sim_top.sv, soc_tb.sv, uart_tx.sv]
2026-10-25 boards: mes2l100hp 上板实测记录——JTAG 认出 PG2L100H、SRAM 下载和串口 OK; flash 实为 XT25BF128 (ID 0xb4018), 固化前要在 Flash Operator 自定义
2026-10-25 ama: fpga program 加 --bit 下载现成位流 (厂商例程) 到 SRAM; cdt_cfg_shell 的 -args 会吃反斜杠, 改传正斜杠路径
2026-10-25 boards: mes2l100hp 首次综合全过并上板跑通 (时序 WNS +1.4, RAM 106/155); GTP_GPLL 删 5 个真原语不认的 PHY 参数; PLL 输出自定义 create_generated_clock (自动命名带竖线, 异步组圈不住); ama report 认 DRM36K
2026-10-25 rtl: 新显示 (720p) 渲染后端
2026-10-25 boards: mes2l100hp flash 固化跑通——XT25BF128 手动加进 PDS flash_list_cd.cfl (ID 0xb4018, 参数抄兼容的 W25Q128Q, 原库备份在 C:/pango/license/); flash.tcl 注释改纯 ASCII (cdt 按 GBK 重编码, 中文注释尾字节会吞换行把 scan 命令并进注释)
2026-10-25 docs: 板 README 记 flash 固化结论 (XT25 手动入库 + ASCII 注释的坑)
2026-10-25 video_demo: 串口报 HDMI 输入掉线 (输入帧停 100 ms / 接收芯片重新锁定), 带帧号
    board_hdmi_poll 返回 ms7200_poll 的结果 (1 = 刚重新锁定); video_demo 改成每帧查一次, 半秒一查会漏短的掉线。
    用来分清小窗黑闪是输入链路断了 (拓展坞) 还是画面本身。
2026-10-26 ama: command() 的 .py 命令经 uv run --script 跑
    Windows 的 CreateProcess 不认 shebang, tests/display 的 prepare
    (直接 exec game/tools/refmodel.py) 在 Windows 起不来。uv 是 ama 自己
    的运行前提, Linux 上行为等价。
2026-10-26 game: 字库在 Windows 上用 Consolas
    font() 找字体原来只有 Menlo (Mac) 和 fc-match (Linux) 两条路, Windows 都
    没有。期望画面 expect.hex 是本机生成本机比对, 字体不同不影响逐点一致。
2026-10-26 rtl: 新显示例化进 soc_top——rib s3 (0x3000_0000), DISPLAY_NEW 参数
    - DISPLAY_NEW=1: s3 接 display (pclk 用板上 74.25 MHz 的 video_clk),
    视频输出口 (pclk/hsync/vsync/de/rgb) 和小窗读改由它驱动
    - 旧 video 留在 s2: 两个引擎不能同时上 (vision 的小窗读口和对外引脚只有
    一套), generate 按参数固定选一路, 综合只留选中的; 改回 0 整体退回
    - vision 的窗口读时钟跟着切: display 在 clk 域读小窗 (下一拍出数),
    旧 video 在扫描时钟读, win_rclk = DISPLAY_NEW ? clk : scan_clk
    - DISPLAY_NEW=0 时 s3 保持原来的保留不握手, 行为与改前一致
    (tests/soc 回归 20/20 PASS, video_demo 校验和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
2026-10-26 tests: 新显示的 SoC 级整帧比对——CPU 走 rib s3 重放场景, 逐点和参考模型比
    - display_tb.sv: soc_top (DISPLAY_NEW=1) + video_sink 收满两帧, 和
    expect.hex 逐点比 (标准同 tests/display); display_check.c 按
    refmodel export --soc 压出来的脚本把一帧写进显示、提交、等生效,
    统计 (LINE_MAX/OVERRUN/DROPPED) 从结束信箱报给测试台
    - refmodel.py export --soc: 总线写压成 (地址, 个数, 数据...) 段的 C
    数组; 数据 0 的写和空白文字格跳过 (显示片内 RAM 复位为 0), 一帧
    压到 ~40 KB 进 ROM (64 KiB 装得下)
    - ama testing.py: program 源文件支持 {out} 占位 (同 plusargs), prepare
    生成的 sc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
2026-10-26 ama: fpga 的 soc.f 解析跳过注释行
    soc.f 直接喂 Verilator (-f), // 和 # 本来就是注释; ama 把所有非 + 行
    当路径, 加了注释就崩在 relpath。
2026-10-26 rtl: disp_render 的位切片显式 $signed
    带符号数的位切片在 Verilog 里是无符号的, 赋给有符号 reg 前加 $signed
    显式标回 (语义等价, 仿真全过; PDS 对这种混用会报符号扩展不一致)。
2026-10-26 boards: mes2l100hp 加 DISPLAY_NEW 参数 (默认 0), 综合被 PDS 段错误阻塞
    - DISPLAY_NEW=1: 画面由新显示 (rib s3) 出; 0: 旧 video。参数已例化链路全通,
    但 **默认 0**: PDS 2022.2-SP6.4 综合新显示时段错误 -- disp_sprites 精灵表
    那对 32x1024 RAM 被装配/合并优化时崩, 20+ 种 RTL 变体和综合开关都绕不过
    (二分定位 + 已排除清单见 docs/display.md, 最小复现 build/fpga/disp_bisect/
    mini.tcl 13 秒崩); DISPLAY_NEW=0 基线综合全过, 位流时序 video_pll +0.356
    - display.md: SoC 级仿真记为已完成 (tests/soc/display_tb 4/4) + 段错误诊断
2026-10-27 docs: display 的 PDS 段错误最小复现 tcl 直接写进文档 (build/ 不进库, 队友/工单拿到就能跑)
2026-10-27 perf(core): 访存地址用单独的加法器, 不再经共享 ALU
    dbus 地址原来走 CSR 读选择 -> ALU 操作数选择 -> 加法, 是 sys_clk 上 CPU 的最差路径
    (ID/EX -> CSR -> ALU -> dbus_addr -> RIB -> GPIO 矩阵, 31 级)。现在 exu_dispatch 直接
    算 rs1 + imm, ALU 去掉 MEM 一路; alu_tb 删掉对应检查。
    mes2l100hp (PDS 2022.2-SP6.4, 50 MHz): 从 CPU 出发的最差余量 +3.662 -> +4.436 ns,
    新最差路径为乘法写回; CPU LUT 3821 -> 3834; CoreMark/MHz 不变 (2.488)。
    整片最差仍是 u_nn (+1.548 ns)。
2026-10-27 nn: 定点化拆成三级流水, 乘法收窄到 33x32
    原来一拍里串着 16 选 1 取累加器、64 位加偏置、64x64 乘法、舍入移位、限幅, 31 级逻辑,
    是整片 sys 时钟的最差路径。现在: 级 1 取累加器加偏置, 级 2 乘 (33x32 取低 64 位, 和原来
    64x64 截 64 位相同), 级 3 舍入移位限幅写 out_word; 每拍仍进一个通道。
    tests/nn 300 个字和 nnref 逐字节一致; 推理 723010 -> 753610 拍 (每个输出单元多 2 拍)。
    mes2l100hp (PDS 2022.2-SP6.4): sys_pll_clk 54.2 -> 65.6 MHz (50 MHz 下 WNS +1.548 -> +4.752),
    最差路径回到 CPU。DSP 数不变 (nn 36)。
2026-10-27 perf(core): 访存请求被接受就放行 EX, load 结果从寄存器堆第二个写口晚写回
    - exu_mem: 请求握手即放行, 记下 rd/宽度/地址低位, 响应那拍经 gpr 第二写口写回
    - gpr_reg: 第二写口, 读口对两个写口都旁路
    - ID 读或写未写回的 load rd 时停 ID 一拍, EX 收气泡 (写也停, 防 WAW)
    - 新增 tests/cpu/loaduse.S (cpu_tb 和 soc_tb 都跑); cpu_tb 提交日志在 load 写回时打印值
    CoreMark/MHz 2.488 -> 2.682; mes2l100hp sys_pll_clk Fmax 65.6 -> 67.4 MHz。
2026-10-27 perf(core): BTB 扩到 128 项, 表项不复位以综合成 RAM
    tag/target/counter 写成不复位的组合读数组, 只有 valid 是寄存器。
    CoreMark 条件分支冲刷 24748 -> 13465 次, CoreMark/MHz 2.682 -> 2.776
    (64 项 2.767, 256 项 2.777)。mes2l100hp: u_btb 846 LUT/1920 FF -> 481 LUT/128 FF + 18 Kb RAM,
    u_core 4764/3868 -> 4190/2209。sys Fmax 64.0 MHz, 最差路径是乘法结果旁路到 ID。
2026-10-27 perf(core): 乘法第一拍就算出 33x33 带符号乘积并寄存, 第二拍只取高/低半
    原来第一拍只寄存操作数, 第二拍求补 -> 乘 -> 64 位求补 -> 写回 -> ID 旁路, 是 sys_clk 最差路径。
    延迟仍是两拍, CoreMark/MHz 不变 (2.776)。mes2l100hp: sys Fmax 64.0 -> 75.2 MHz,
    u_core LUT 4190 -> 3633。extensions.S 补上四种乘法的符号/边界组合和连续相关的乘法。
2026-10-27 perf(core): 乘法第一拍算 33x33 带符号乘积并寄存, 第二拍只选高低半
    原来第一拍寄存操作数, 第二拍求补-乘-64 位求补再接写回和 ID 旁路, 是 sys_clk 最差路径。
    mes2l100hp: sys Fmax 64.0 -> 75.2 MHz, u_core LUT 4190 -> 3633; CoreMark 周期不变。
    extensions.S 补乘法符号/边界组合和连续相关乘法 (旧实现同样通过)。
2026-10-27 perf(core): BTB 表项强制用 LUT RAM (syn_ramstyle=select_ram), 不占 DRM
    不加属性时 PDS 把一部分放进 DRM (108 -> 108.5 块)。加了之后 DRM 回到 108, u_btb 500 LUT/128 FF,
    sys Fmax 77.3 MHz。
2026-10-27 perf(core): 返回地址栈 (RAS) 预测 ret, 其它 jalr 用 BTB 记下的上次目标
    - BTB 表项加类别 (普通/调用/返回); jalr 也训练进表
    - ras.v: 4 项, 取指投机压栈/弹栈, EX 更新提交栈, 冲刷时投机栈换成提交栈
    - 预测目标随指令流到 ID, ID 算好 "预测目标 - imm", EX 只比 rs1 (不经过目标加法器)
    - tests/cpu/ras.S: 深递归、改 ra 后 ret、函数指针换目标、跳转表、远调用、奇数 imm、
    rs1 恰好等于上次目标的误命中; 破坏 EX 核对或 ID 减 imm 都会被抓到
    CoreMark jalr 冲刷 10920 -> 414 次, CoreMark/MHz 2.776 -> 2.865 (栈深 8 相同)。
    mes2l100hp: u_ras 141 LUT/260 FF, u_core 3665 -> 39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
2026-10-27 perf(core): 分支比较用 exu 里单独的比较器, 不再经共享 ALU
    原来 rs1/rs2 比较要经过和 CSR 读数据同一个与或选择, 是 "分支解析 -> 冲刷 -> fetch_pc" 的大头。
    共享 ALU 只留跳转目标的加法; alu_tb 去掉比较用例 (cpu 的 alu.S 覆盖六种分支的边界,
    把有符号比较换成无符号会被抓到)。mes2l100hp sys Fmax 68.6 -> 78.8 MHz, LUT 基本不变。
2026-10-27 rtl: disp_blend 的加法和半透明合成一条乘加, 绕过 PDS 综合段错误
    PDS 2022.2-SP6.4 综合 DISPLAY_NEW=1 时 mod-gen 段错误 (signal 11, Flow-0189) 的真正触发点
    是 blend: 加法 d + ((s * a) >> 4) 和半透明 (s * a + d * (16 - a)) >> 4 共用乘积 s * a 再按
    mode 选。加法改成系数取 16 的同一条乘加, (s * a + d * 16) >> 4 == d + ((s * a) >> 4), 逐位
    相同 (每通道 x mode x alpha 穷举 655360 组一致), 仿真 11/11 逐点一致。
    之前归咎于精灵表那对 RAM 是二分混淆 (不崩的变体都把 w1 置 0, flags 恒 0, blend 被优化掉);
    disp_render 里 "不加 $signed 会段错误" 的注释也不成立, 改成只说语义。
    Co-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
2026-10-27 rtl: 新显示除图案库和文字层外的表改用 LUT RAM, mes2l100hp 的 DRM 138 -> 123.5 块 (79.7%)
    DISPLAY_NEW=1 时存储全放 DRM 要 138/155 块 (89%), 超过 80% 的目标。加 dpram_lut / dpram2c_lut
    (和 dpram / dpram2c 一样, 存储标 syn_ramstyle = "select_ram"), 调色板、工作行、显示行、对象列表、
    图案表、背景图块表、字库和精灵表都换成它: 新显示 34.5 -> 20 块 DRM, 多约 5000 LUT。
    整片 LUT 22.1%, APM 43.8%; WNS sys +4.161 / video +7.109 / hdmi_rx +4.664 ns, hold 全为正。
2026-10-27 docs: display 的 PDS 段错误改记真正的触发点和 15 行复现, 补 mes2l100hp 综合结果
    boards: mes2l100hp 的 DISPLAY_NEW 注释改成 "置 1 能综合"; 默认仍为 0 (新显示的 C 后端还没写,
    现有 demo 画在旧 video 上)。顺带更正: 之前记的 video_pll_clk +0.356 是 hold 余量, 不是 setup。
2026-10-27 perf(core): 寄存器堆改用 LUT RAM (两写口按 LVT 选组), 不再用 32x32 个触发器
    两个写口 (提交 / load 晚写回) 各写一组 RAM, 每组复制两份给两个读口; 32 位 LVT 记下每个寄存器
    最后由哪个写口写。同拍写的旁路不变。破坏 LVT 选择 (只读提交那组) 时 cpu 测试 15 项失败。
    mes2l100hp: u_gpr_reg 907 LUT/992 FF -> 162 LUT/32 FF, u_core 3930/2412 -> 2920/1452,
    sys Fmax 79.7 MHz (最差路径已不在 CPU 内), DRM 不变。CoreMark/MHz 不变 (2.865)。
2026-10-27 model: 训练用 CUDA、直接吃 model/data 并按人留出验证集; 结构试验选项; 文档补多人录数据和汇总的流程
    - train.py: 有 NVIDIA 显卡用 cuda; 参数可以给装着 session 的目录 (只取标注过的);
    --val-person 按人 (meta.json 的 person) 留出验证集; 开训前按人、场景打印帧数
    - handnet.py: --dw-k 5 (不缩小的块用 5x5 深度卷积)、--extra N (多 N 个不缩小的块), 存进 .pt
    - nn_export.py: 宽度和结构从 .pt 读, 硬件不支持的结构直接报错; --calib 可以给数据目录
    - docs/hand-model.md: 录、标注、汇总 (session 目录放进 model/data 即可)、训练、导出的完整步骤; 结构试验表
2026-10-27 model: 导入 HaGRID 照片当外部数据 (import_hagrid.py, 按人分组、裁成我们摄像头的手大小), label.py 支持照片逐张标注; 记 5x5 深度卷积和 HaGRID 的对比结果
2026-10-27 rtl: UART 接收加 16 字节 FIFO, CPU 算一帧时连着来的字节不再互相覆盖; 软件接口不变 (写 STATUS 清 bit1 = 取走一个)
2026-10-27 ama: app.toml 加 prepare (编译前生成) 和 params (位流的顶层参数, 算进硬件版本号; sim 跟着用 mes2l100hp); run/monitor --pad 手柄窗口
2026-10-27 game: 板上后端 (gfx.h -> 新显示寄存器、串口键盘输入) 和 sw/app/game: 标题选游戏, 东方式 / 水果忍者式用键盘玩; ama sim 里两个游戏画面都出来了
2026-10-27 nn: 深度卷积支持 5x5 (层表的核大小 1/3/5, 补边 k/2), dw3、dw4 改成 5x5: 7.06 M 乘加, 一次推理 792010 拍; nn_export.py --dw-k 3 仍可导出旧结构
2026-10-29 tools(ama): 自动推断 fpga board 并修复 pds 烧写失败检测
    1. 自动推断板卡：
    在未指定 但指定 时，通过检查
    下已生成的位流自动推断板卡。这避免了依赖串口芯片猜测，
    解决了盘古 USB Cable II (同为 FT2232) 接入时被误识别为 ego1 的问题。
    2. 修复 pds (cdt_cfg_shell) 烧写失败检测(在我家里的电脑)：
    - 烧写 flash 前清理旧的 和 ，防止残留文件干扰判断。
    - 增强失败判定： 失败时脚本会直接停止且无 输出，
    现增加对日志中 的检查，并验证 是否真实生成且非空。
    - 优化错误提示：当检测不到下载器 () 时，明确提示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
    [cli.py]
2026-10-30 Add OV7670 camera monitor firmware
2026-10-30 Document OV7670 camera monitor setup
2026-10-31 coremark: 和 game 同参数 (DISPLAY_NEW = 1), 硬件版本号相同, 跑分和游戏共用一份位流
2026-10-31 coremark: 编译选项换成扫出来最好的一组 (-O2 -funroll-all-loops -mtune=sifive-7-series -msmall-data-limit=8 -mrelax -flto), 仿真 CoreMark/MHz 2.865 -> 3.075
2026-10-31 tests: CoreMark 流水线逐拍归因 (coremark_perf_tb, 仿真里的 ILA): 计时区间 CPI 1.210, load-use 7.5%, 分支预测错 4.1%, 访存 hold 2.3%, 取指气泡 0; +trace 导出逐拍波形 CSV
2026-10-31 game: 串口改成通用帧格式, pad.py 发 'P' 帧
    link.{h,c} 把串口字节流拆成终端打的字和 [0xFF][类型][长度][数据][校验] 帧;
    手柄改用 'P' 帧, 鼠标右键 = B。主机测试 link_test.c, RTL 仿真验过鼠标位置。
2026-10-31 game: 输入方式 (按键 / 指点) 和 MENU 暂停菜单
    同一时间只有一种来源控制游戏, 只在暂停菜单里切换: 按键 = 方向键 / A / B / 慢速,
    指点 = 鼠标或手, 左键 = A、右键 = B。MENU = m / q / 单按 Esc, 重开和 MENU 哪种方式都能用。
    鼠标右键单独一位 PAD_RCLICK; pad.py 去掉 m 开关鼠标, 鼠标在窗口里就发。
    RTL 仿真验过: Esc 开菜单、切到 point, 按键方式下鼠标不起作用。
2026-10-31 nn: 硬件抓帧 (box4 小图 -> 输入 RAM) 后自动推理, C 接口 nn_capture
    CTRL bit2 抓下一个完整帧; box4 的 160x120 经 8x24 异步 FIFO 跨到系统时钟,
    写进原输入 RAM (同样的 BGR / XOR 0x80); crop 验证整帧后自动开始推理, 坏帧报
    STATUS bit3 不推理。抓帧和推理期间屏蔽 CPU IN 写入, 原来 CPU 送图的方式保留。
    capture_tb 640x480 / 800x600 / 1280x720 逐像素比对, capture_cdc_tb 断流 / 溢出 / 复位。
2026-11-01 firmware: 链接加 -Wl,--build-id=none, 修上电一片静默
    ELF 的 .note.gnu.build-id 是 alloc 段且落在地址 0, 顶掉了程序第一条指令; bootloader 的
    .text 同样被顶到 0xF824, 而 RESET_PC 是 0xF800。于是 CPU 一复位执行的就是 note 数据
    (非法指令), 整块设计完全静默 —— 不闪灯、无串口、HDMI 无信号, 看起来像"FPGA 没启动"。
    加 --build-id=none 后 .text 从 0x0 开始, bootloader 正好落在 0xF800。对所有 app 生效。
    复核: build/fw/mes50hp/camera/rom.hex 第一个字是 10010117 (不再是 00000004),
    0xf800 处是 bootloader 的第一条指令。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
    [firmware.py]
2026-11-01 ov7670: 帧缓存改 RGB565, 原尺寸显示, 未出帧时彩条回退
    - ov7670_vga: 帧缓存每像素 8 位 (RGB332) 改 16 位 (RGB565)。蓝通道原来只有 2 位,
    既造成偏色, 也把亮度低于 1/8 的像素直接截成 0 (暗部全压死)。画面改为 160x120 左上角
    原尺寸显示、其余纯黑; 还没收到完整帧时同一区域输出 8 条彩条, 用来单独确认扫描通路。
    另加 2x 饱和增益 (brighten) 缓解偏暗。新增 frame_ready_o 输出, 供板顶层接状态灯。
    - ov7670_sccb_init: 寄存器表 4 条 -> 30 条。原来只写软复位/RGB/RGB565/TSLB, 自动曝光、
    自动增益、自动白平衡全没打开, gamma 也没写, 这是画面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
2026-11-01 soc_top: 新增 NN 参数, 可整个关掉 handnet 加速器
    PGL50H 的 134 块 DRM18K 里 handnet 加速器要占约 108 块, 不关掉连基础位流都过不了
    device map。soc_top 新增参数 NN (默认 1, 行为不变), 置 0 时整个加速器不综合,
    0x4000_6000 这一口保留但不握手 (和 DISPLAY_NEW=0 时 s3 的做法一样)。
    mes50hp_top / mes2l100hp_top 同名参数透传下去, 所以 app.toml 里写
    params = { NN = 0 } 就能关掉, 不用改 RTL。
    回归: ./ama test tests/soc/soc_tb.sv -> 13 PASS / 0 FAIL (含 nn_check, 默认值未改变原行为)
    [mes2l100hp_top.v, mes50hp_top.v, soc_top.v]
2026-11-01 mes50hp: 相机状态灯、PCLK 布线约束、SCCB 上拉, 新增彩条 app
    板顶层
    - 新增 UART_BREAK_RESET 参数 (默认 1, 行为不变)。板上 CP2102 没接线时 UART_RX 悬空会被
    当成持续 break, 把整个 SoC 压在复位里; camera 应用把它置 0。
    - OV7670_MONITOR=1 时 LED1~LED3 接成相机状态灯: SCCB 完成 / SCCB 出错 / 收到过完整帧。
    HDMI 数据改用专用脚后 LED 不再复用, 串口又没接, 这是唯一的固件侧观测手段。
    约束 (mes50hp.fdc)
    - PCLK 走 J8_25/U8, 是普通 IO 不是专用时钟脚, 默认 place 阶段报 E:Place-0084。
    按 UCE 2.3.4.9 / 2.3.4.2 设 PAP_CLOCK_ASSIGN=GENERAL 和 PAP_CLOCK_DEDICATED_ROUTE=FALSE,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
2026-11-01 ama: 相机参数的程序用 mes50hp 顶层仿真
    sim_binary() 原来只要 app.toml 有 params 就选 mes2l100hp 顶层, 而那个顶层没有
    OV7670_MONITOR / UART_BREAK_RESET, 所以 ./ama sim camera 直接报
    Parameter not found, 相机通路只能靠 ov7670_vga_tb 单独仿真。
    改成: params 里出现 OV7670_MONITOR 时用 mes50hp, 其余照旧用 mes2l100hp。
    验证: ./ama sim camera --frames 3 打印 boot / HDMI out: no answer,
    截图是左上角 8 条彩条 + 其余纯黑 (无摄像头模型时的彩条回退), 扫描通路正确。
2026-11-01 docs: 新增 OV7670 摄像头 -> HDMI 文档, 修正过期的 RGB332 描述
    新增 docs/ov7670.md, 单篇覆盖:
    - 硬件接线 (原根目录 camera_pin.md 全文并入, 该文件删除): 接口身份 (J8 = External_B/J16)、
    16 根信号的方向/J8 脚号/网络名/FPGA 管脚/io 下标/RTL 宏、电源与地、电气与时序约定。
    - 与板载 ST7789 的冲突 (抢 J8_23~28, 不能同时用)。
    - 数据通路、关键文件表、app.toml 三个参数各自为什么必须这么设。
    - ./ama 构建下载三条路径: 带 --app camera 的位流; 只改 C (需串口); 无板子的仿真。
    含排错表 (E:Place-0084 / hwid 不一致 / 下载线被 ftdi_sio 占用 / cdt_cfg_shell 假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
2026-11-01 docs: 新增 OV7670 在线调参方案 (UART 实时改寄存器)
    回答"能不能写个电脑软件, 通过 UART 实时改摄像头参数来方便调画面":
    结论
    - 曝光/增益/白平衡/gamma/亮度/颜色格式/字节顺序全是 SCCB 寄存器, 能实时改;
    改完下一帧就在 HDMI 上看到 (一包 4 字节约 0.35 ms, 一次 SCCB 写约 0.3 ms, 一帧 16.7 ms)。
    - **聚焦不能**: OV7670 是机械对焦环, 没有对应寄存器。
    - 障碍不在 UART, 而在两处现状: ov7670_sccb_init 是上电跑完 30 条就停的自动机, 没有 CPU 接口;
    相机模式下顶层把 J8_21/22 从 GPIO 矩阵手里独占 (mes50hp_top 的 g_camera_scl/g_camera_sda),
    固件连 bit-ban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
2026-11-02 core: 上板 ILA 探针 (ila_ 前缀, 打一拍并加保留属性, PDS Inserter 里按名字找); exu 引出 mem_stall_o
2026-11-02 game: 指点方式接上板上 handnet (硬件抓帧自动推理), ama sim --vin 喂图
    game/board/handnet.c 每帧看一眼 NN 状态, 出结果就解码再抓下一帧 (约 30 次/秒),
    小图坐标 x4 给 hand_update; 指点方式下没鼠标就听手。暂停菜单多一行 handnet 结果数 / 坏帧 / 置信度。
    仿真: tests/nn/in.raw 放大成 800x600 当 HDMI 输入, 识别 (83,51) 张开, 自机到 (175,135), 和期望输出算的一致。
2026-11-02 tools(ama): pad.py 认手柄 (Xbox 布局, pygame-ce 的 SDL GameController)
    十字键 / 左摇杆 = 方向, A / B, LB / RB / 扳机 = 慢速, Start = MENU, Back = 重开,
    和键盘按的合在一起发 'P' 帧, 板子不用改。插拔、蓝牙重连收到事件就重新打开。
    自测: (tools/ 下) uv run --with pygame-ce python -m ama.xpad; Xbox Series 手柄蓝牙实测方向 / A / B / 慢速。
2026-11-02 core: ILA 探针异或进保留的汇点寄存器 (Fabric Inserter 不列出无负载的网)
2026-11-02 game: 手从 hand_source 拿 (默认板上 handnet), 侧栏常驻 handnet 速率 / 推理时间 / 置信度
    hand_source.c: 游戏取手的入口, 弱符号, 默认 handnet_poll; handnet 记下每次推理的拍数。
    pad: 'P' 以外的帧交给 on_frame (以后的设备)。ama.local.toml 可给程序附加本机的
    sources / include / cflags ([app.<程序>]); ama test 的主机测试也用 app.toml 的 include。
2026-11-02 tools: cam_hdmi.py, USB 摄像头画面画到接 FPGA HDMI 输入的屏上
    板子没有直接接摄像头的接口: 镜像、裁成 640x480 画在屏幕正中, 正好是 FPGA crop 裁下的那块。
    全屏窗口 (电脑) 或直接写 /dev/fb0 (没有桌面的小板子)。
2026-11-02 core: ILA 探针改用 PAP_MARK_DEBUG 精确标记 (0 号核 trigger port 0 通道 0..34, 采样时钟 <0/c0/0>), Inserter 打开时自动连好; PC 逐位声明 (多位信号的标记综合后会丢)
2026-11-02 tools(cam_hdmi): 读摄像头放后台线程, 不设 BUFFERSIZE=1, 帧率在分辨率之后设; --exposure 锁曝光
    BUFFERSIZE=1 时 V4L2 每取一帧就丢下一帧 (15 帧/秒)。实测 USB 摄像头 15 -> 22 帧/秒, 锁曝光 15 ms 约 25 帧/秒。
2026-11-02 boards: mes2l100hp 引脚表加 GameShield (EXTIOB J2) 的 34 个信号脚
    名字按 HOST 版用途 (CAM_*, WS_*, PHY_*, AMP_*, EXT29-34, EXP35/36), 焊盘来自
    ~/hw/game-shield/pins.csv 的 100H 列; 全部 inout 进 GPIO 矩阵, 接什么由 C 决定。
    前提: J20 跳线帽在 3V3+[6.7] (FMC bank 6/7 为 3.3V)。
    W19 (WS_RX) 在 HDMI_IN_DDR3 例程里叫 free_clk, 手册里是 LA05_N, 上板时确认。
    [pins.csv]
2026-11-02 hdmi: MS7200 输入补设置改成从不稳定变稳定就写, game 主循环每 4 帧查一次
    上板实测 0x209E 低 2 位上电后从 01 直接变 10 (不经过 00), 或第一次读就是 10;
    例程只认 00 -> 10, 补设置不写就不出图, 时好时坏。game 之前完全没调 board_hdmi_poll,
    小窗一直黑。video_demo 两次实测都在第 53/54 帧自动锁上, 输入量到 1280x720。
2026-11-02 hdmi: 板子的 EDID 改成自己的 "AMa FPGA", 首选 1280x720@60 (tools/edid.py 生成)
    例程的 EDID 是一台三星 4K 显示器的, 电脑插上默认给 4K, 每次要手动改分辨率。
    新 EDID 只声明 720p 和 640x480, 只收 RGB, 带 HDMI 标识; 厂商代号 AMQ (AMA 已被注册)。
    edid-decode -c 无警告通过; 上板实测电脑认出 "AMQ AMa FPGA", 自动出 1280x720。
2026-11-02 rtl+sw: 第二个串口 UART2 (0x4000_7000), 经 GPIO 矩阵接任意脚
    - soc_top 再例化一个 uart 挂外设子总线第 6 口 (0x4000_7000), 上电收发脚都不接
    - gpio_matrix: 输出信号 4 = UART2_TX, 输入信号 2 = UART2_RX (不接时空闲电平 1);
    FUNC_IN_SEL 地址留 4 个 (0x400~0x40C), 3 号保留, 写丢弃读 0
    - C: amarisc.h 加 UART2, io.h 加 SIG_UART2_TX/RX 和 IO_NONE;
    bsp/aux_uart.h 写本板 UART2 接在哪 (mes2l100hp: WS63 的 WS_TX/WS_RX), aux_uart_init 接脚并打开
    - 测试: gpio_matrix_tb 覆盖新信号和保留口; soc_tb 加 +loopback (输出脚电平送回输入),
    uart2_check 把 UART2 收发接到 J8_3 上回环收发, 并查上电不接、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
2026-11-02 nn: 权重换成训练好的 handnet (宽度 16, 5x5 深度卷积), 用录的数据标定量化
    之前 rtl/nn 里是 nn_export.py 不带 .pt 时的固定种子随机权重, 只用来验证 RTL。
    model/nn_export.py model/runs/cmp_k5b.pt --calib model/data (16 个 session 抽 64 帧标定)。
    结构不变 (10 层, 7.06 M 乘加, 792010 拍); tests/nn 300 个输出字和模型逐位一致。
2026-11-02 game: pad 两个串口都收, 控制台口和 UART2 来的字和 'P' 帧一样处理
    - pad_t 每个字节源一个 pad_port_t (link 解析器、ESC 状态、最后一个 'P' 帧的按键/鼠标), 两个口交错着来不会互相打断
    - 各口 'P' 帧的按键合起来; 一个口 PAD_STALE (30) 帧没来 'P' 帧, 它的按键和鼠标作废 (无线断了不会一直按着)
    - 鼠标位置: 鼠标在窗口里的口优先, 只有一个口时和原来一样每帧更新
    - pad_poll API 不变, 拆成 pad_begin / pad_byte / pad_end 三步, 电脑上的测试只编这部分 (PAD_NO_UART)
    - game 主程序开机 aux_uart_init(115200) (mes2l100hp: WS63 星闪)
    - 主机测试 link_test.c 改名 input_t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
2026-11-02 rtl+sw: 声音外设 (0x4000_8000), 3 方波 + 1 噪声声道, I2S 经 GPIO 矩阵输出
    - rtl/perips/audio.v: 每个采样相位 += FREQ; 方波按 DUTY 出 ±VOL×32, 噪声 15 位 LFSR (长/短周期);
    四个声道相加成 16 位 (最大 32640 不溢出); LEN 计到 0 自动清 VOL; 不用块 RAM
    - 标准 I2S: 48 kHz, 64 BCLK 一帧, 一位延迟, 16 位高位对齐补 0, 左右同一个样本, 不出 MCLK (MAX98357A 直接吃);
    BCLK 由 50 MHz 相位累加 (同 i2s_beep spike), CTRL.EXACT 改成 clk/16 无抖动 (48.828 kHz); EN=0 时钟停
    - gpio_matrix 输出信号 5/6/7 = I2S_BCLK / I2S_LRCK / I2S_DOUT
    - C: amarisc.h 加 AUDIO, drivers/audio.h (AUDIO_HZ / AUDIO_MS, audio_tone / b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
2026-11-02 app: shield_demo, GameShield 上按键响声、第二个串口回显并和控制台串口互转
2026-11-02 nn: 加 IN_READ (0x24), CPU 空闲时能读回输入 RAM 的像素 (nn_get)
    抓到的 160x120 以前只能写不能读, 板上识别差时没法看板子实际吃进去的画面。
    读口在空闲时接 IN_ADDR, 忙时还是引擎的地址; 读出来还原成写入格式 {0, R, G, B}。
    nn_tb 加抽查 198 个像素读回一致, 推理结果仍和参考实现逐位一致。
2026-11-02 nn_grab + model/board_grab.py: 把板子 handnet 实际看到的画面取回电脑
    板上收到 'g' 就抓一帧推理, 回结果和 160x120 RGB; 电脑存 png, 用 nnref 复算 (应和板子一致),
    打印每个通道的最小/平均/最大值 (看电脑 HDMI 是不是有限范围 16~235、亮度够不够)。
2026-11-02 cam_hdmi: 自己找接 FPGA 的屏 (EDID "AMa FPGA"), 全屏且不抢键盘焦点
    Hyprland 按显示器名字找, 运行时加窗口规则 (那块屏、全屏、no_focus), 窗口出来后把焦点还给原窗口;
    Windows / X11 / macOS 用 screeninfo 找不是主屏的 1280x720 (EDID 只给 720p), Windows 设 WS_EX_NOACTIVATE。
    以前要手动把窗口拖过去, 全屏窗口还会吃掉键盘, 看起来像死机。--screen WxH 保留老办法。
2026-11-02 cam_hdmi: 不许聚焦的窗口按地址补全屏 (Hyprland 的全屏规则对它不生效)
    上板实测: 自动找到 HDMI-A-1 (AMa FPGA), 全屏 1280x720, 焦点一直留在原来的终端。
2026-11-02 GameShield 程序分成两个: shield_host (100HP, 功放 + WS63) 和 shield_pad (50K, 无线手柄)
    shield_demo 改名 shield_host。shield_pad: 读 J8 上 9 个键 + 摇杆 4 个方向 (按下接地),
    每秒 60 个 'P' 帧经 UART2 -> WS63 发给主机, 格式同 tools/ama/pad.py (主机 game 从第二个串口收)。
    aux_uart.h 加 mes50hp: WS_TX = J8_19, WS_RX = J8_20 (40P 排线, 针号和扩展板 J1 一样)。
    帧用 game 的 link 解析器在电脑上核对过。
2026-11-02 game: 音效层 (core/sound) + 电脑版声音外设模型 (pc/audio_sdl)
    - core/sound.{c,h}: 音效表 (每个音效最多两步: 起止频率/音量、帧数、占空比、颤音), 方波 0~2 + 噪声按优先级抢占; PCM 留给音乐
    - 两个游戏和菜单的事件处调 sound_play, 主循环每帧 sound_frame; 板上 board/sound_hw.c 接 drivers/audio.h
    - pc/audio_sdl.c: SDL 48 kHz 逐样本模拟声音外设 (方波/噪声/LEN/PCM FIFO/饱和混音), --mute, 没声卡照常跑
    - game/test: 声音模型对照测试 (make -C game check-audio)
2026-11-02 声音: PCM 流声道 + 同一路 I2S 同时送 HDMI (MS7210)
    - audio.v: PCM 声道 (0x50~0x5C: CTRL/DATA/LEVEL/VOL), 2048 样本 FIFO (512x32, 一字 4 个 8 位样本), DIV 降采样, 欠载计数; 混音改 16 位饱和
    - soc_top 引出 i2s_bclk/lrck/dout, mes2l100hp 顶层固定接 MS7210 的 T23/B25/P26 (和 GPIO 矩阵到功放那路并行)
    - pins.csv 加 port 列: 直连顶层的专用脚, 不占 GPIO 编号 (ama gen pins / check 同步)
    - ms7210.c: 音频寄存器 + Audio InfoFrame (48 kHz, 2 声道, 16 位), 失败时画面照常 (移植自 HDMI 音频 spike)
    - drivers/audio.h: audio_pcm_enable/space/write/volume; 测试: audio_tb PCM 各项、soc audio_check、MS7210 I2C 注错
    [pins.csv]
2026-11-02 固件: 按函数/数据分段并 --gc-sections, 链接时丢掉没用到的代码
    game 把整套 LCD 驱动链了进去却不用, ROM 省 3.4 KB, 不影响速度。启动段 .text.init 加 KEEP。
2026-11-02 game: 100HP 板上 KEY1~4 当第三个输入源, 标题和暂停菜单显示哪些输入源活着
    - board/local_keys.h: KEY1 = A, KEY2 = MENU, KEY3 = RESTART, KEY4 = SLOW (去抖复用 components/key), 和两路串口按键取或
    - 标题、MENU 加只读一行 'pad: usb sle keys': 最近 PAD_STALE 内有输入的亮绿, 否则灰
    - input_test 补本地按键合并、源活跃判断
2026-11-02 mes2l100hp: 板载 MicroSD 卡槽 (J10) 的 SPI 五根线接进 GPIO 矩阵
    SD_SCK F19 / SD_MOSI H14 (CMD) / SD_MISO F18 (DAT0) / SD_CS H15 (DAT3) / SD_DET G19 (插卡检测), L3 bank 3.3 V; 依据教程1 §2.1.3.4.4
    [pins.csv]
2026-11-02 SD 卡素材: 只读 SPI SD + FAT32 连续文件 AMA.PAK, 立绘和 PCM 背景音乐
    - sw/components/sd: SPI 模式 SD 驱动 (SDv1/SDSC/SDHC, CMD17 单块读), pak.c 在 FAT32 根目录找 AMA.PAK (要求连续), 一个扇区缓存
    - sw/bsp/board_sd.h: 接线; sw/app/sd_test: 上板读卡测试
    - game/tools/pack.py: game/assets/portraits/*.png、bgm/* → AMA.PAK (立绘量化到保留的调色板段、切块; 音乐转 16 kHz 8 位单声道)
    - 立绘: gfx.h 加接口, 板上从 PAK 读进图案库 + 调色板, 电脑版同一份量化; 背景音乐: bgm_play/stop/frame 每帧按 PCM FIFO 空位从卡上填
    - 东方式进关示范调用; 没卡/没包/没素材时照常; 占位素材全部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
2026-11-02 game: 开机素材压缩存放, 开机解压 (ROM 省 21 KB)
    refmodel.py firmware 把 (偏移, 个数, 数据...) 段的字节流用 lz_pack 压缩 (原样段 / 4 KB 内回指复制两种头), 25.7 KB -> 4.4 KB,
    生成时自己解一遍核对。gfx_hw.c 开机按同一格式解, 最近 4 KB 输出放栈上的环里 (显示的内存读不回来)。
    game .text 63.9 KB 超限 -> 46.5 KB; 电脑上 C 解码结果和参考解码逐字一致。
2026-11-02 声音: wav 音效软件混进 PCM 声道 (音乐 + 最多 4 路音效)
    - pack.py: game/assets/sfx/*.(wav|mp3|ogg) -> PAK 音效项 (16 kHz 8 位, 单个最长 1 秒); 开机读进 12 KB 音效池, 放不下的跳过并报名字
    - core/mix: 背景音乐 + 4 个音效声部饱和相加, FIFO 水位保持约 800 样本 (延迟 ~50 ms); 同名重触发从头放
    - sound.c 音效表可指定 wav 名字: 有文件放 wav, 没有用原来的合成参数; 板上和电脑版共用 media_audio.c
    - 测试: 混音饱和/水位/声部抢占/缺 wav 回退, SDL 集成; check-sd 13 项
2026-11-03 声音: pcm_test 上板自测 PCM 声道, game 串口报 PCM 欠载
    - sw/app/pcm_test: 不用 SD 卡, 内存合成 16 kHz 正弦按游戏节奏喂 (每帧补到 800), 串口每秒报采样率/水位/欠载;
    按键切正弦/音阶/PCM 与方波交替/停喂/写满/EXACT/音量。和 game 同一位流 (DISPLAY_NEW=1)
    - game 每 5 秒一行加 pcm underrun +N; drivers/audio.h 加 audio_pcm_underruns
    - core/mix: 声音停后再补 5 帧静音才关 PCM, 不等 FIFO 放空 (放空起每次取样都记欠载, 每个音效结束白涨最多约 267)
    - 上板 (100HP + MAX98357A): 48000 Hz, 水位最低 531, 欠载 0; 停喂 0.2 s 涨 2668; 写满 2048 后多写被丢;
    PCM 正弦和方波都能听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
2026-11-03 docs/audio: HDMI 出声上板确认 (采集卡录到 440 Hz/音阶, 和功放同时)
2026-11-03 game/README: 删掉素材来源的限制说明
2026-11-03 game/tools/gen_sound.py: 程序合成 8 个短音效 + 12.8 秒循环 BGM, 交给 pack.py 打包
2026-11-03 shield_pad: 关掉 handnet (NN = 0), 否则 PGL50H 块 RAM 不够, map 报 LUT 不足
    已编出位流: LUT 19%, RAM 69%, sys_clk 50 MHz 能跑到 61.6 MHz, WHS +0.047
2026-11-03 docs/guide.md: 队友上手指南 (接线、开机、按键和菜单、开发环境、改游戏从哪下手), README 加链接
2026-11-03 boards/mes50hp: flash.tcl 注释改纯 ASCII (同 mes2l100hp)
    cdt_cfg_shell 按 GBK 重编码脚本, 中文注释吞掉换行, cfg_jtag_flash_scan_device 不执行,
    写 flash 报 'There is no flash device'。改后 shield_pad 写进 50K flash 成功。
2026-11-04 fpga: pnr 加 multi-corner 保持时间修复, 100HP 游戏位流 slow corner 不再违例
    PDS 默认只按 fast corner 修 hold, slow corner 剩 PC 到分支预测表一条 -0.011 ns;
    加 -fix_hold_violation -optimize_multi_corner_timing 后 sys WHS slow +0.028 / fast +0.017 ns,
    All Constraints Met。guide.md 同步。
    [fpga.py]
2026-11-04 shield_pad: 关掉 UART_BREAK_RESET
    手柄只插电源时 CP2102 没接, 控制台 RX 悬空被当成持续 break, 设计一直压在复位里 (同 camera 应用)。
